galpavlin/BESC-G2/pictures/besc g2 bottom.png

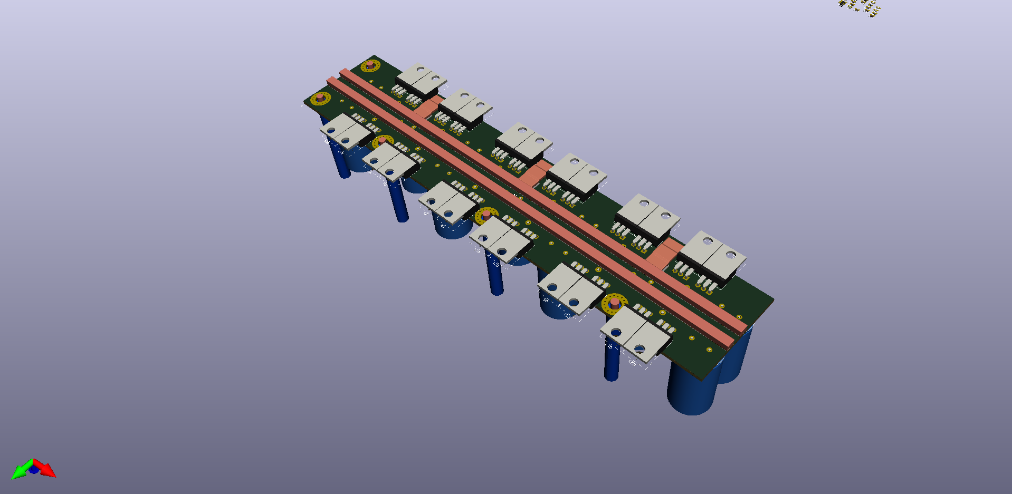
pictures/besc g2 bottom.png
