galpavlin/BESC-G2/pictures/besc g2 power stage layout.JPG

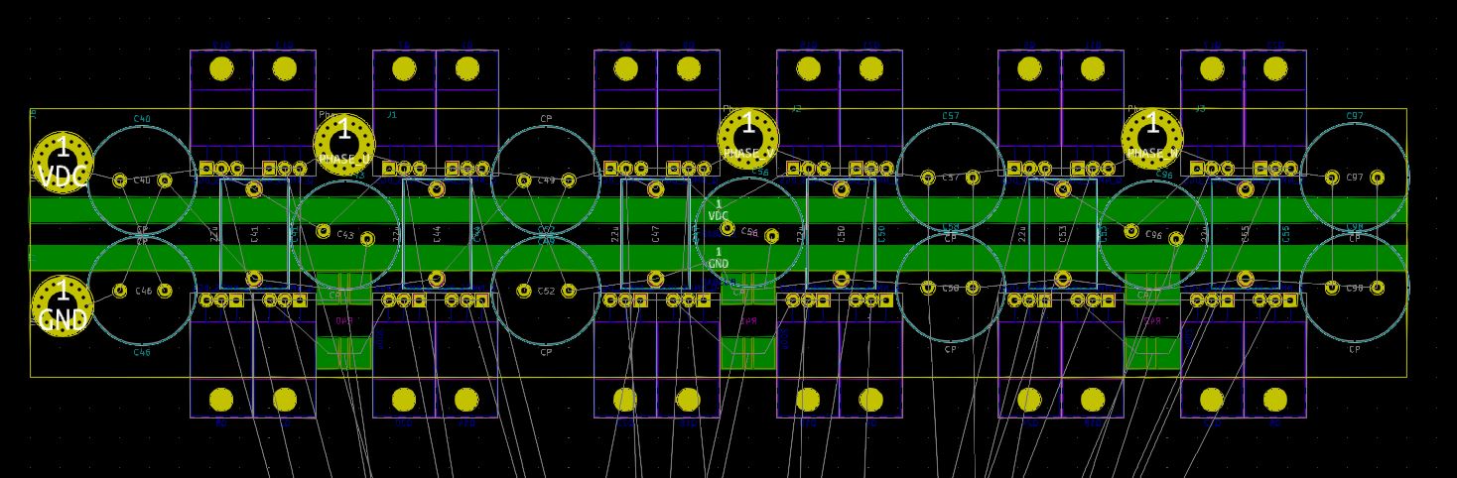
pictures/besc g2 power stage layout.JPG
