galpavlin/BESC-G2/pictures/besc g2 top.png

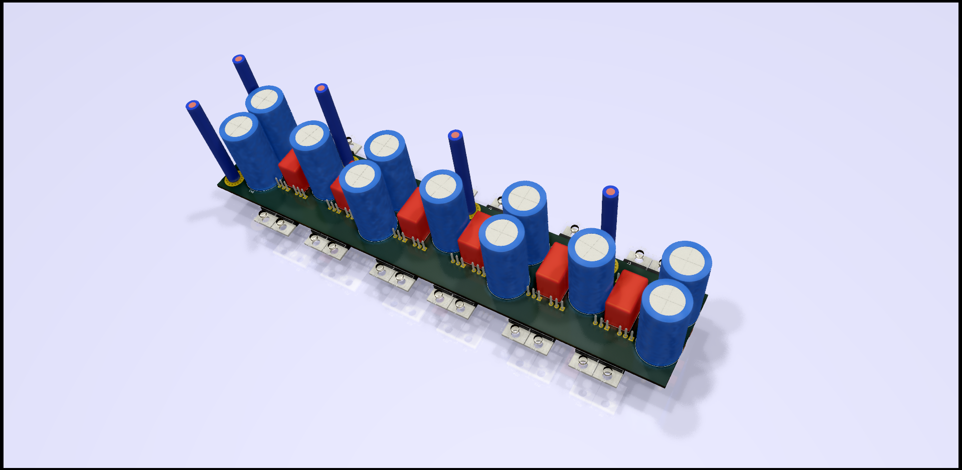
pictures/besc g2 top.png
