galpavlin/BESC-G2/documentation/BESC G2 V1.1 BOM.ods

Designator | Value | Footprint | Quantity | manufacturer # | mouser # | farnell #
> C1-C3 | 2.2u 35V | Capacitor_SMD:C_0805_2012Metric | 3 | C2012X7R1V225M085AC | 810-C2012X7R1V225M8A
> C4-C9, C13-C15, C65-C67, C104 | 270p | Capacitor_SMD:C_0603_1608Metric | 13 | C0603C271J5GACTU | 80-C0603C271J5G
> C19-C24, C100, C110-C112, C114 | 4.7u 25V | Capacitor_SMD:C_1206_3216Metric | 11 | VJ1206Y475KXXTW1BC | 77-VJ126Y475KXXTW1BC
> C25-C30, C75, C77, C79-C81, C85, C91 | 10n | Capacitor_SMD:C_0603_1608Metric | 13 | 885012206089 | 710-885012206089
> C10-C12, C16-C18, C31-C33, C63, C68-C71, C74, C82, C84, C86-C88, C90, C96, C101 | 100n | Capacitor_SMD:C_0603_1608Metric | 23 | 885012206071 | 710-885012206071
> C34-C39, C54, C62, C64, C76, C78, C83, C89, C95, C99, C102, C103, C106, C109 | 2.2u | Capacitor_SMD:C_0603_1608Metric | 19 | 885012207001 | 710-885012207001
> C40, C43, C46, C49, C52, C56-C61 | B41858C9477M000 | Capacitor_THT:C_Radial_D18.0mm_H25mm_P7.50mm | 11 | B41858D9337M000 | 871-B41858D9337M
> C41, C44, C47, C50, C53, C55 | F611BY685K100A | Capacitor_THT:C_Rect_L18.0mm_W11.0mm_P15.00mm_FKS3_FKP3 | 6 | F611BY685K100A | 80-F611BY685K100A | 2808222
> C42, C45, C48, C51 | C1206C105K1RACTU | Capacitor_SMD:C_1206_3216Metric | 4 | C1206C105K1RACTU | 80-C1206C105K1R
> C72, C73 | 15p | Capacitor_SMD:C_0603_1608Metric | 2 | 885012006052 | 710-885012006052
> C92-C94, C98 | 0.47u 200V | Capacitor_SMD:C_1210_3225Metric | 4 | MC1210B474K201CT | 80-C1210X474K1RAUTO | 1855950
C97 | 100u | Capacitor_Tantalum_SMD:CP_EIA-6032-28_Kemet-C | 1 | TAJD107M016RNJ | 581-TAJD107M016R
C105 | 130p | Capacitor_SMD:C_0603_1608Metric | 1 | GRM1885C1H131GA01D | 81-GRM1885C1H131GA1D
C107 | 47n | Capacitor_SMD:C_0603_1608Metric | 1 | 885012206044 | 710-885012206044
C108 | 10p | Capacitor_SMD:C_0603_1608Metric | 1 | 885012006051 | 710-885012006051
> C115-C117 | TR3D157K016C0075 | Capacitor_Tantalum_SMD:CP_EIA-7343-31_Kemet-D | 3 | TR3D157K016C0075 | 74-293D157X9016D2TE3 | 2353189
> D1-D3 | SS115+ | Diode_SMD:D_SMA | 3 | SS115+ | 821-SS115F3 | 2675131
D7 | MMSZ5231BT1G | Diode_SMD:D_SOD-123 | 1 | MMSZ5231BT1G | 863-MMSZ5231BT1G | 1431273
D9 | 12.7V | Diode_SMD:D_SMA | 1 | SMAJ12A-TR | 511-SMAJ12A-TR | 9802754
> FB1-FB3, FB7, FB8 | BLM18AG102SN1D | Inductor_SMD:L_0603_1608Metric | 5 | BLM18AG102SN1D | 81-BLM11A102S
IC1 | LTC7801 | Package_DFN_QFN:QFN-24-1EP_4x5mm_P0.5mm_EP2.65x3.65mm | 1 | LTC7801EUFD#PBF | 584-LTC7801EUFDPBF
J10 | 614105150721 | Connector_USB:USB_Micro-B_Wuerth_614105150721_Vertical_CircularHoles | 1 | 614105150721 | 710-614105150721
J17 | 12V OUT | conn-amass:AMASS_XT30U-M_1x02_P5.0mm_Vertical | 1 | XT30U |  |  | check TME for original | you can get knockoff on ebay
L1 | 7443633300 | moje:WE-HCF-2013 | 1 | 7443633300 | 710-7443633300
> Q1-Q24 | IRF135B203 | moje:TO-220-3_hor_tabup | 24 | IRF135B203 | 942-IRF135B203 | 2709931
Q25 | FDMS86252L | moje:TDSON-8-MOS | 1 | FDMS86252L | 512-FDMS86252L
Q26 | BSC110N15NS5 | moje:TDSON-8-MOS | 1 | BSC110N15NS5 | 726-BSC160N15NS5ATMA | 2803377
> R1-R9, R83, R86 | 60R4 | Resistor_SMD:R_0603_1608Metric | 11 | CRCW060360R4FKEAC | 71-CRCW060360R4FKEAC
> R10-R12 | 2.2R | Resistor_SMD:R_1206_3216Metric | 3 | RCG12062R20JNEA | 71-RCG12062R20JNEA
> R13-R18, R22-R24, R66-R73, R75, R76, R79-R82 | 2k2 | Resistor_SMD:R_0603_1608Metric | 23 | CRGCQ0603F2K2 | 279-CRGCQ0603F2K2
> R31-R33 | 200u | moje:LRMAP5930x | 3 | LRMAP5930B-R0002FT | 66-LRMAP5930BR0002FT
> R25-R30, R34-R51, R93 | 10R | Resistor_SMD:R_0805_2012Metric | 25 | CRCW080510R0FKEAC | 71-CRCW080510R0FKEAC
> R52, R54, R56, R63 | 150k | Resistor_SMD:R_0805_2012Metric | 4 | CRCW0805150KFKEA | 71-CRCW0805-150K-E3
> R53, R55, R57, R64 | 3k24 | Resistor_SMD:R_0603_1608Metric | 4 | CRCW06033K24FKEA | 71-CRCW0603-3.24K-E3
> R58, R59, R61, R62 | 1R | Resistor_SMD:R_1206_3216Metric | 4 | RCG12061R00JNEA | 71-RCG12061R00JNEA
> R19-R21, R60, R92 | 10k | Resistor_SMD:R_0603_1608Metric | 5 | SFR03EZPF1002 | 755-SFR03EZPF1002
> R74, R87 | 330R | Resistor_SMD:R_0603_1608Metric | 2 | CRCW0603330RFKEAC | 71-CRCW0603330RFKEAC
> R77, R78 | 24R | Resistor_SMD:R_0603_1608Metric | 2 | RC0603FR-1324R9L | 603-RC0603FR-1324R9L
> R84, R85, R94 | 30k1 | Resistor_SMD:R_0603_1608Metric | 3 | CRCW060330K1FKEA | 71-CRCW0603-30.1K-E3
R88 | 1M | Resistor_SMD:R_0603_1608Metric | 1 | RC0603FR-071ML | 603-RC0603FR-071ML
R89 | 9k1 | Resistor_SMD:R_0603_1608Metric | 1 | RC0603FR-079K1L | 603-RC0603FR-079K1L
> R90, R91, R96 | 80k6 | Resistor_SMD:R_0603_1608Metric | 3 | CRCW060380K6FKEA | 71-CRCW0603-80.6K-E3
R95 | 71.5k | Resistor_SMD:R_0603_1608Metric | 1 | CR0603-FX-7152ELF | 652-CR0603FX-7152ELF
R97 | 255k | Resistor_SMD:R_0603_1608Metric | 1 | RC0603FR-13255KL | 603-RC0603FR-13255KL
R98 | 60k4 | Resistor_SMD:R_0603_1608Metric | 1 | CR0603-FX-6042ELF | 652-CR0603FX-6042ELF
R99 | 4k32 | Resistor_SMD:R_0603_1608Metric | 1 | RC0603FR-074K32L | 603-RC0603FR-074K32L
TH1 | 10k | Resistor_SMD:R_0603_1608Metric | 1 | NCU18XH103F6SRB | 81-NCU18XH103F6SRB
> U1-U3 | UCC21520DW | Package_SO:SOIC-16W_7.5x10.3mm_P1.27mm | 3 | UCC21520DWR | 595-UCC21520DWR
> U4-U6 | INA240A1D | Package_SO:SOIC-8_3.9x4.9mm_P1.27mm | 3 | INA240A1D | 595-INA240A1D
U8 | STM32F405RGTx | Package_QFP:LQFP-64_10x10mm_P0.5mm | 1 | STM32F405RGT6 | 511-STM32F405RGT6
U9 | USBLC6-2SC6 | Package_TO_SOT_SMD:SOT-666 | 1 | USBLC6-2SC6 | 511-USBLC6-2SC6
U10 | TJA1051T-3 | Package_SO:SOIC-8_3.9x4.9mm_P1.27mm | 1 | TJA1051T-3 | 771-TJA1051T/3/1J
U11 | R-78E5.0-0.5 | Converter_DCDC:Converter_DCDC_RECOM_R-78E-0.5_THT | 1 | R-78E5.0-0.5 | 919-R-78E5.0-0.5
U12 | LP5907MFX-3.3 | Package_TO_SOT_SMD:SOT-23-5 | 1 | LP5907MFX-3.3 | 595-LP5907MFX-3.3NPB
Y1 | MCSJK-7I-8.00-18-10-60-B-10 | Crystal:Crystal_SMD_5032-4Pin_5.0x3.2mm | 1 | MCSJK-7I-8.00-18-10-60-B-10 | ECS-80-8-30Q-VY-TR | 2854012
Stuff that's probably already somewhere on your workbench
D4 | RED | LED_SMD:LED_0603_1608Metric | 1 | common 0603 LED
D5 | GREEN | LED_SMD:LED_0603_1608Metric | 1 | common 0603 LED
D6 | BLUE | LED_SMD:LED_0603_1608Metric | 1 | common 0603 LED
D8 | LED | LED_SMD:LED_0603_1608Metric | 1 | common 0603 LED
> FID1-FID6 | Fiducial | Fiducial:Fiducial_0.5mm_Mask1.5mm | 6 | mechanical
> H1-H9 | M3 | MountingHole:MountingHole_3.2mm_M3_Pad_Via | 9 | mechanical
> J1-J3 | PHASE WIRE | moje:8awg_wirepad | 3 | 8 AWG silicone wire BLUE + cable lug
> J4, J5 | BUSBAR | moje:busbar1 | 2 | 3x4x230 square copper profile
J6 | IN+ | moje:8awg_wirepad | 1 | 8 AWG silicone wire RED + cable lug
J7 | IN- | moje:8awg_wirepad | 1 | 8 AWG silicone wire BLACK + cable lug
J8 | SWD | Connector_PinHeader_2.54mm:PinHeader_1x05_P2.54mm_Vertical | 1 | common 2.54 5 pin header
J9 | RC PWM | Connector_PinHeader_2.54mm:PinHeader_1x03_P2.54mm_Vertical | 1 | 3 pin JST cable assembly | https://www.aliexpress.com/item/32889207283.html?spm=2114.search0104.3.2.201e7038qpjDAU
J11 | THROTTLE | Connector_PinHeader_2.54mm:PinHeader_1x03_P2.54mm_Vertical | 1 | 3 pin JST cable assembly | https://www.aliexpress.com/item/32889207283.html?spm=2114.search0104.3.2.201e7038qpjDAU
J12 | MOTOR SENSOR | Connector_PinHeader_2.54mm:PinHeader_1x06_P2.54mm_Vertical | 1 | 6 pin JST cable assembly | https://www.aliexpress.com/item/32889207283.html?spm=2114.search0104.3.2.201e7038qpjDAU
J13 | THROTTLE 2 (BRAKE) | Connector_PinHeader_2.54mm:PinHeader_1x03_P2.54mm_Vertical | 1 | 3 pin JST cable assembly | https://www.aliexpress.com/item/32889207283.html?spm=2114.search0104.3.2.201e7038qpjDAU
J14 | SERIAL | Connector_PinHeader_2.54mm:PinHeader_1x05_P2.54mm_Vertical | 1 | 5 pin JST cable assembly | https://www.aliexpress.com/item/32889207283.html?spm=2114.search0104.3.2.201e7038qpjDAU
J15 | IGNITION | Connector_PinHeader_2.54mm:PinHeader_1x02_P2.54mm_Vertical | 1 | 2 pin JST cable assembly | https://www.aliexpress.com/item/32889207283.html?spm=2114.search0104.3.2.201e7038qpjDAU
J16 | CAN | Connector_PinHeader_2.54mm:PinHeader_1x04_P2.54mm_Vertical | 1 | 4 pin JST cable assembly | https://www.aliexpress.com/item/32889207283.html?spm=2114.search0104.3.2.201e7038qpjDAU
thermal interface pad |  |  | 85 cm^2 | 0.5mm thermal silicone pad | https://www.ebay.com/itm/400mm-x-205mm-x-0-5mm-Silicone-Thermal-Pad-for-CPU-GPU-Heatsink-AD/112077304497
enclosure | 45x120x240 mm | you have to aks for custom lenght | 1 | SZOMK AK-C-B68 | https://www.aliexpress.com/item/1445241428.html
PCB |  |  | 1
