galpavlin/BESC-G2/3d/bus bar.SLDPRT

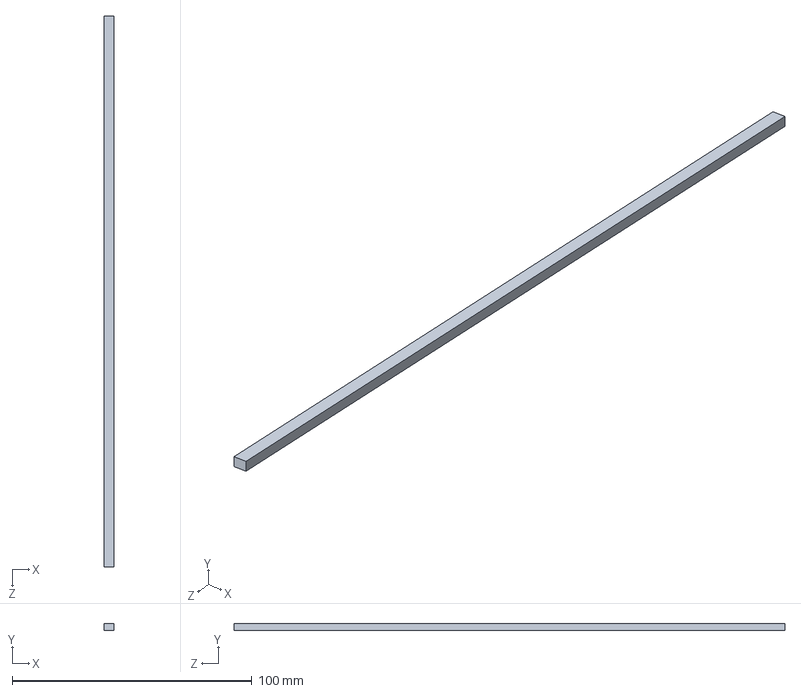
[picture p4: CAD file, 2019-08-21]
3d/bus bar.SLDPRT
4.00 x 3.00 x 230.0 mm
