galpavlin/BESC-G2/3d/enclosure/3d print/top plastic 1.STL

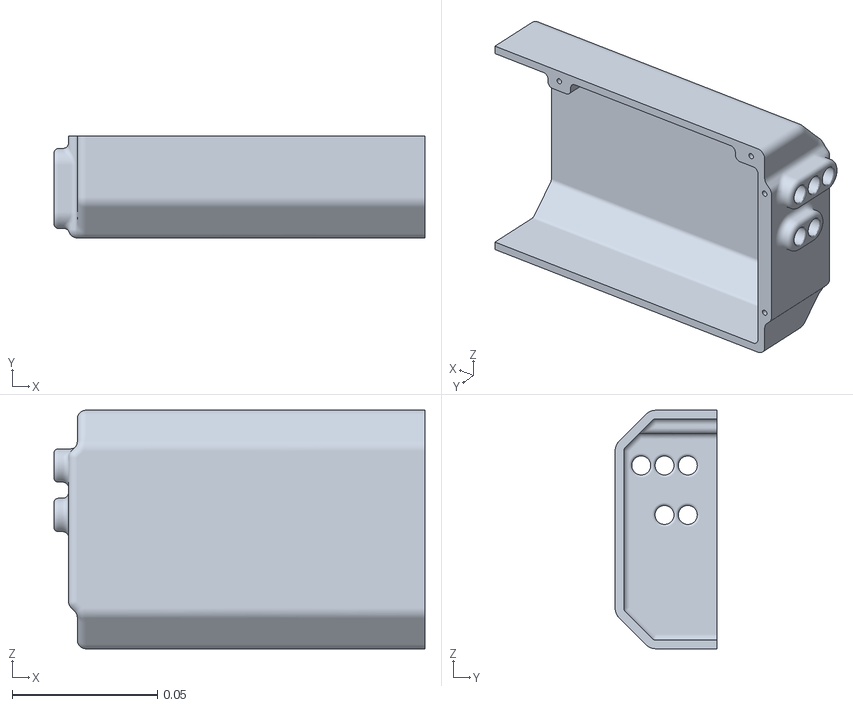
[picture p5: CAD file, 2020-08-25]
3d/enclosure/3d print/top plastic 1.STL
0.127 x 0.035 x 0.082
