galpavlin/BESC-G2/3d/enclosure/3d print/spacers2.STL

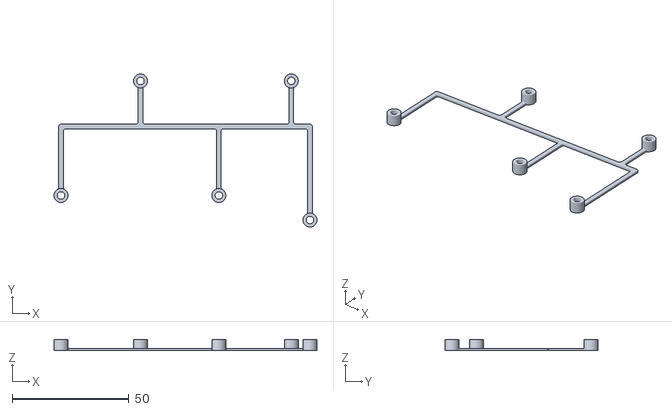
[picture p6: CAD file, 2020-08-25]
3d/enclosure/3d print/spacers2.STL
112.5 x 65.5 x 4.80
