galpavlin/BESC-G2/3d/enclosure/3d print/spacers1.STL

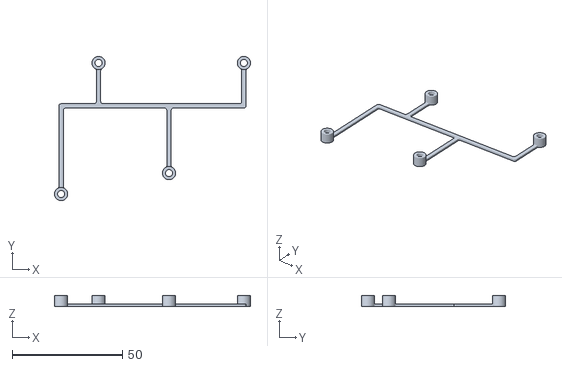
[picture p7: CAD file, 2020-08-25]
3d/enclosure/3d print/spacers1.STL
89.0 x 65.5 x 4.80
