galpavlin/BESC-G2/3d/enclosure/3d print/top plastic.STEP

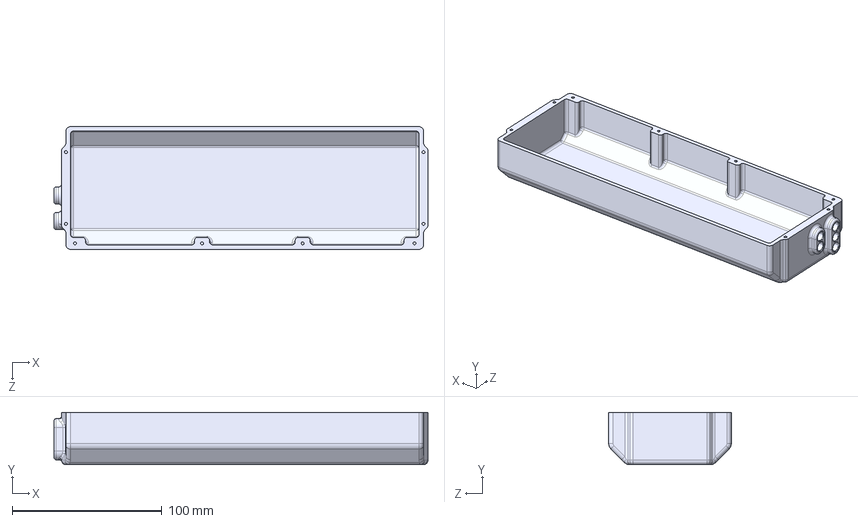
[picture p8: CAD file, 2020-08-25]
3d/enclosure/3d print/top plastic.STEP
250.0 x 35.0 x 82.0 mm
