galpavlin/BESC-G2/3d/enclosure/3d print/top plastic 2.STL

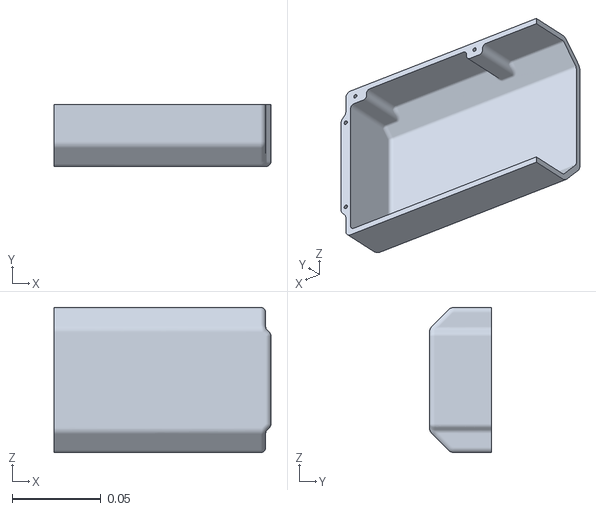
[picture p9: CAD file, 2020-08-25]
3d/enclosure/3d print/top plastic 2.STL
0.123 x 0.035 x 0.082
