galpavlin/BESC-G2/3d/enclosure/3d print/spacers.STL

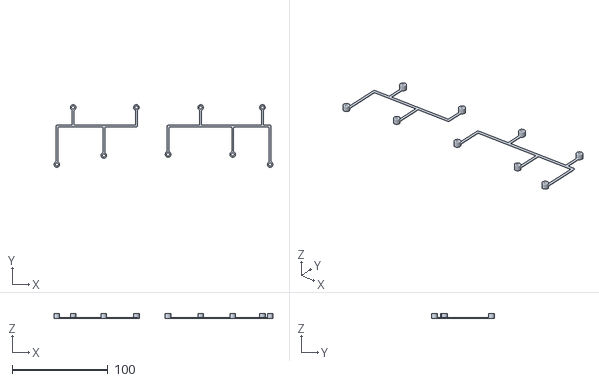
[picture p10: CAD file, 2020-08-25]
3d/enclosure/3d print/spacers.STL
228.5 x 65.5 x 4.80
