galpavlin/BESC-G2/documentation/besc g2.pdf

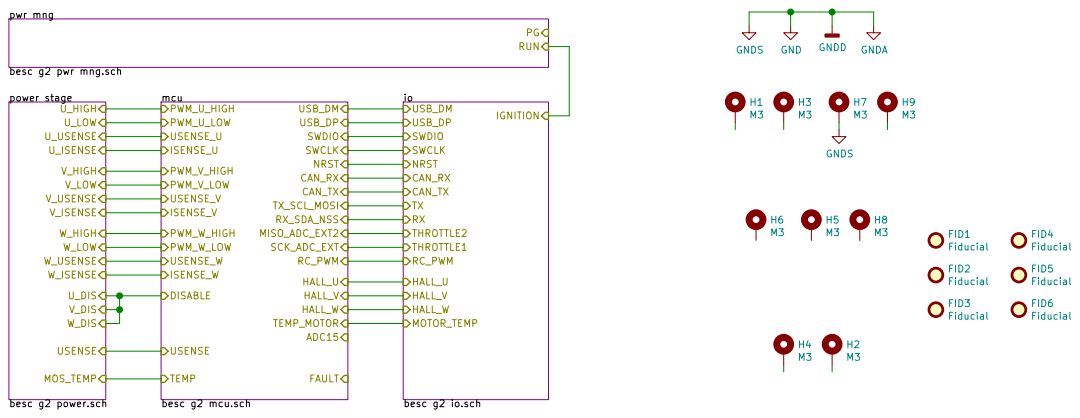
[picture p11: page 1]

RUN
besc g2 io.sch CAN_TX CAN_RX NRST SWDIO
SWCLK RC_PWM
FAULT CAN_RX CAN_TX

File: besc g2.sch Sheet: / e.pavlin.si

Id: 1/5 Title: BESC Gen 2

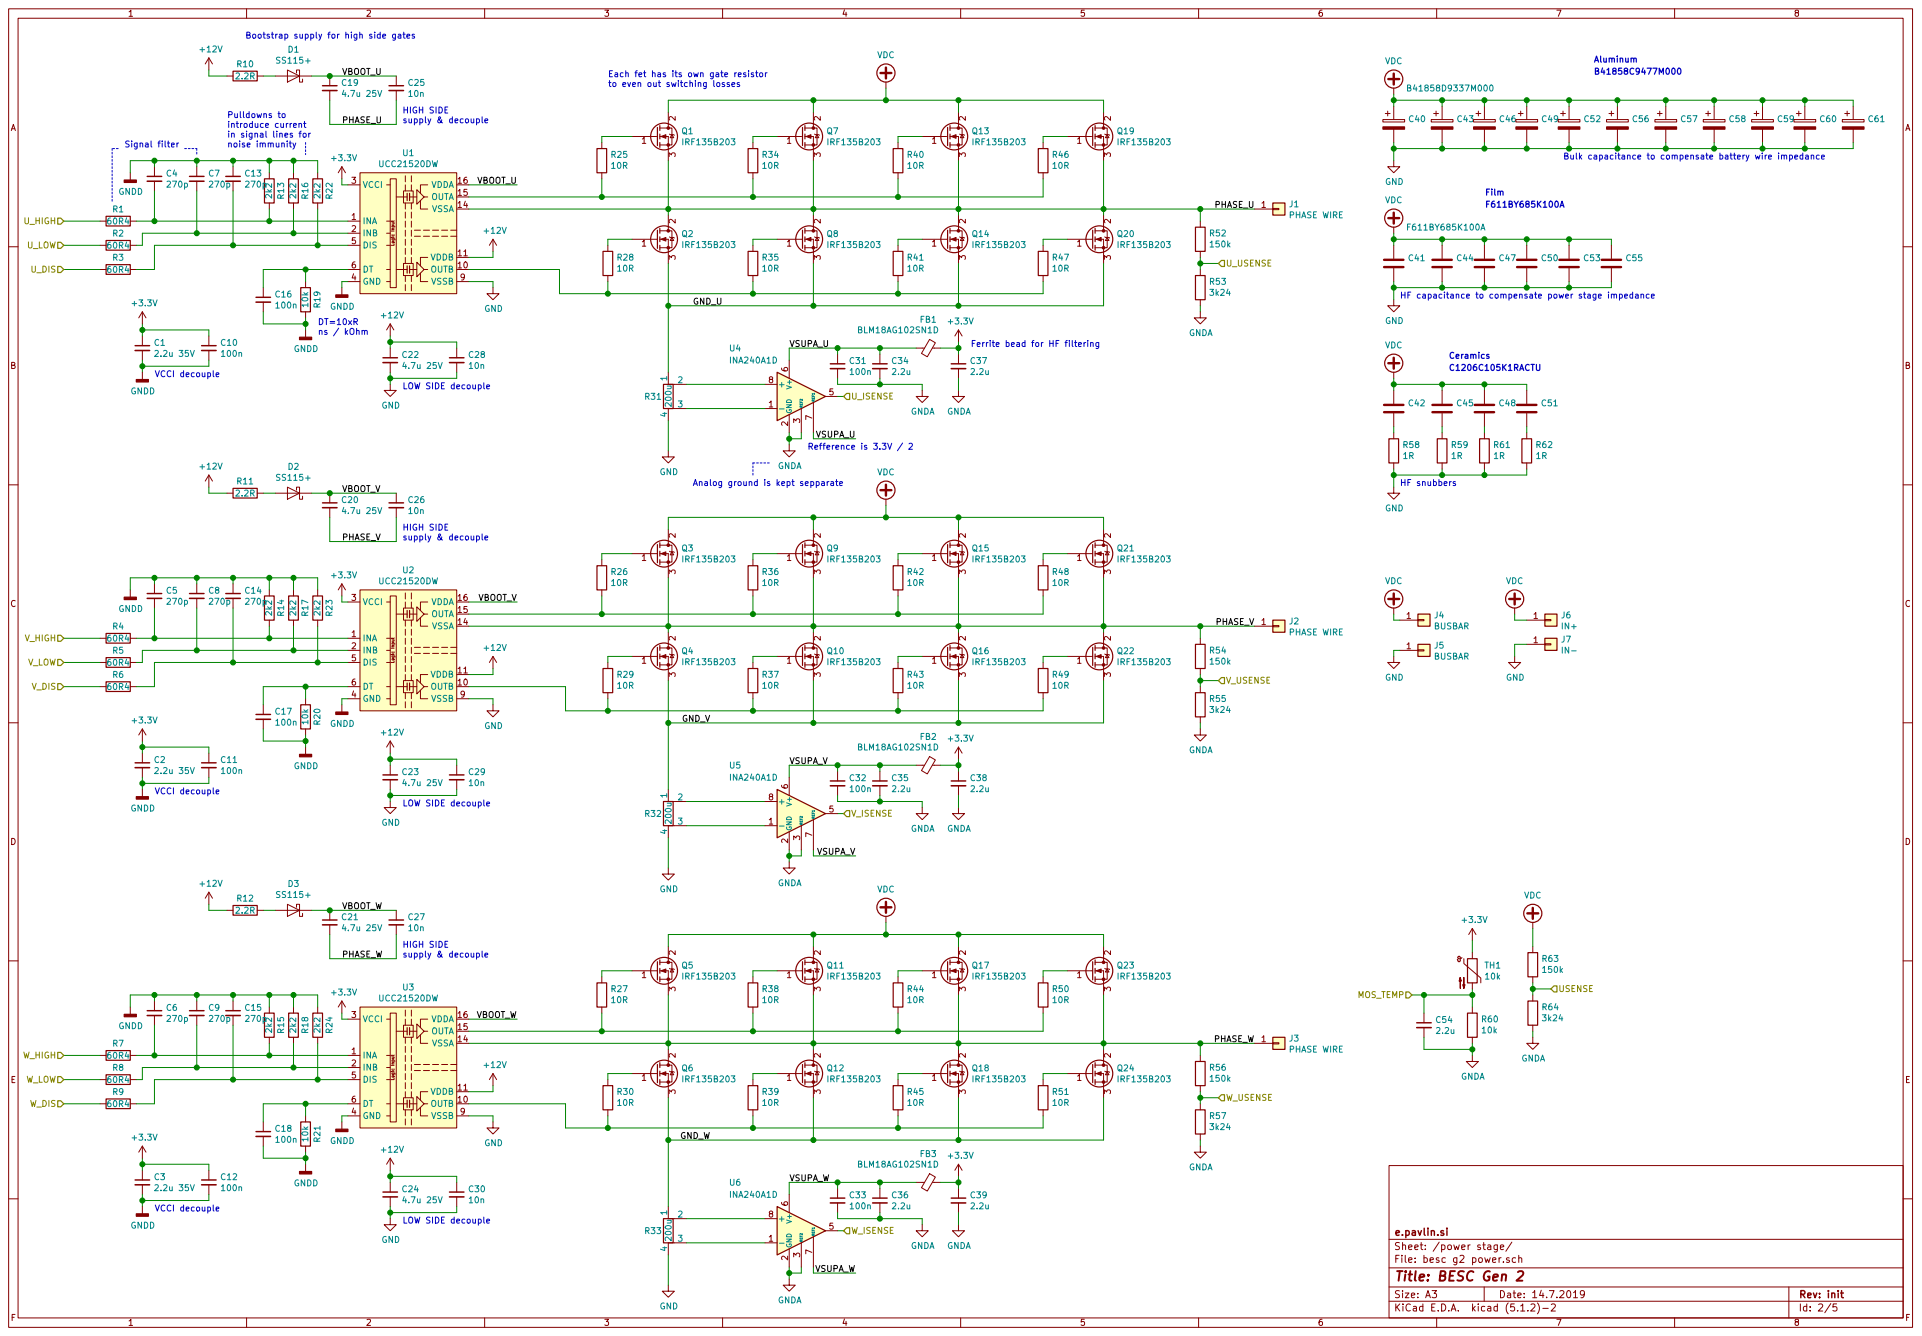
[picture p12: page 2]

Bootstrap supply for high side gates

Each fet has its own gate resistor
to even out switching losses

HF capacitance to compensate power stage impedance HF snubbers Pulldowns to
introduce current
in signal lines for
noise immunity

Bulk capacitance to compensate battery wire impedance

Analog ground is kept sepparate C22
10n GND

e.pavlin.si
Sheet: /power stage/
File: besc g2 power.sch
Id: 2/5 Title: BESC Gen 2

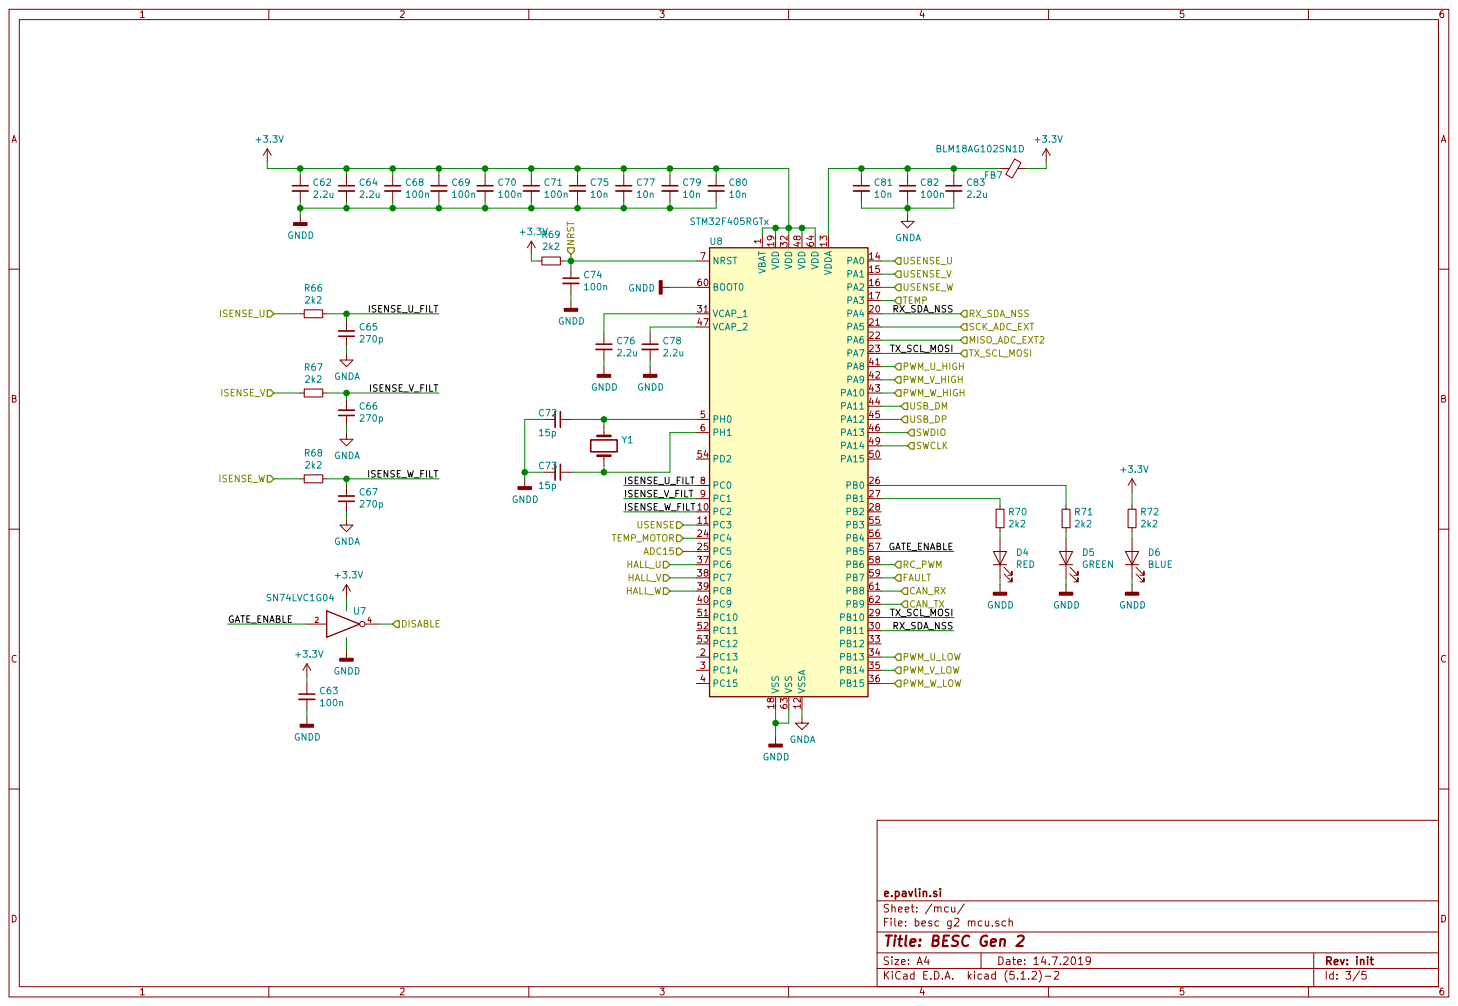
[picture p13: page 3]

1 VCAP_1 31 VCAP_2 47 VDD 19 VDD 32 VDD 48 VDD 64 VDDA 13 VSS 18 VSS 63 VSSA 12 U8 STM32F405RGTx PWM_U_HIGH

File: besc g2 mcu.sch Sheet: /mcu/ e.pavlin.si

Id: 3/5 Title: BESC Gen 2

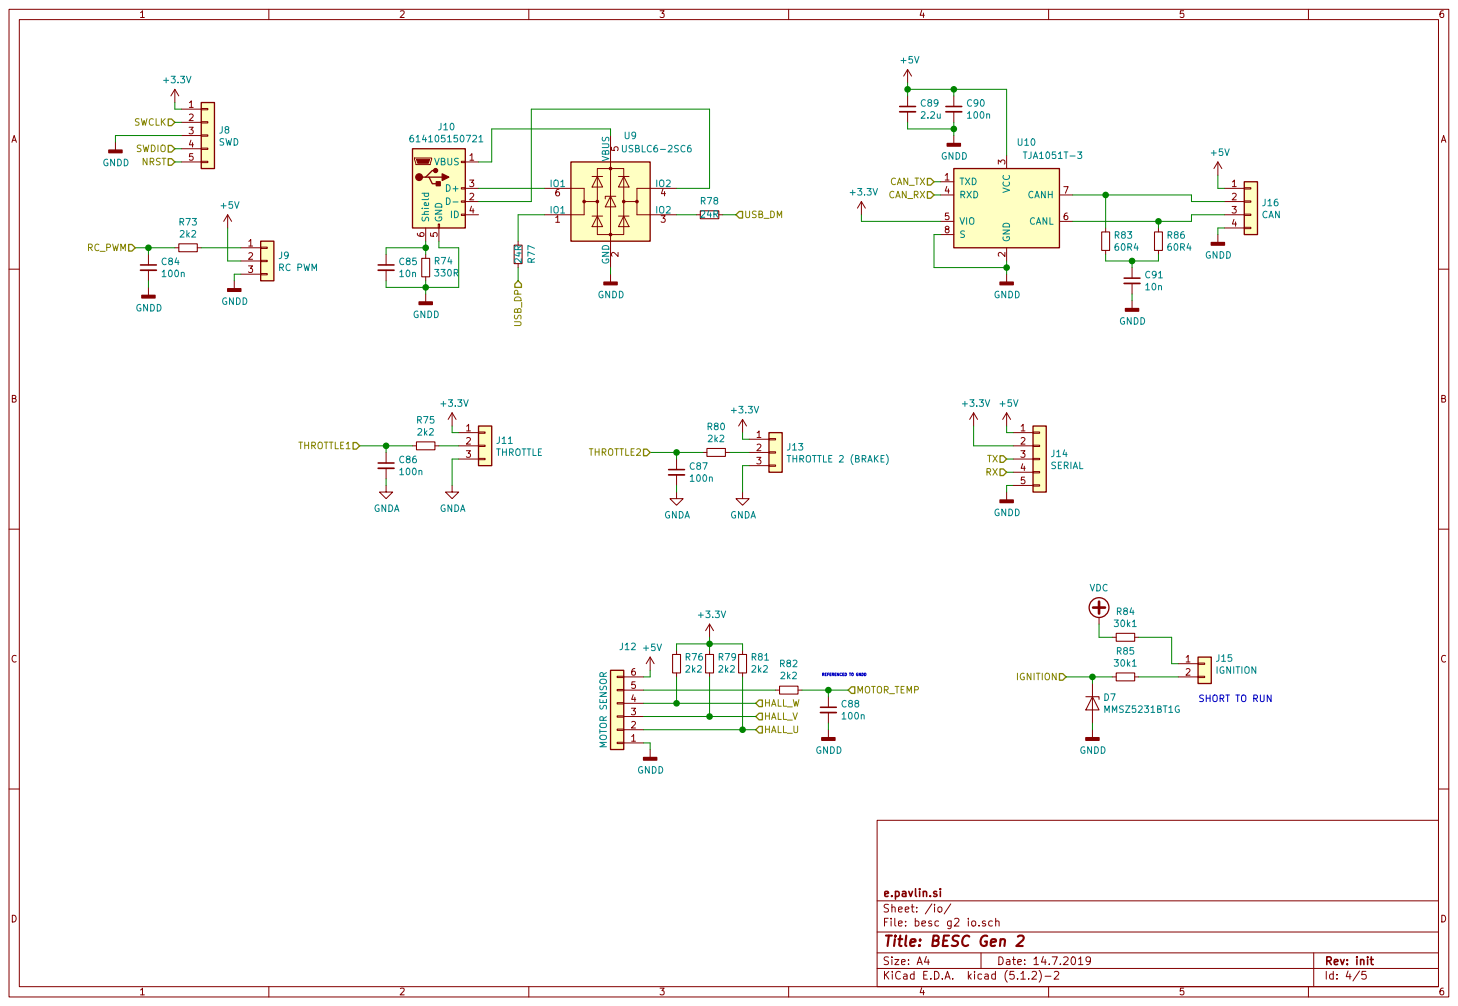
[picture p14: page 4]

3 RXD 4 VIO 5 CANL 6 CANH 7 S

File: besc g2 io.sch Sheet: /io/ e.pavlin.si

Id: 4/5 Title: BESC Gen 2

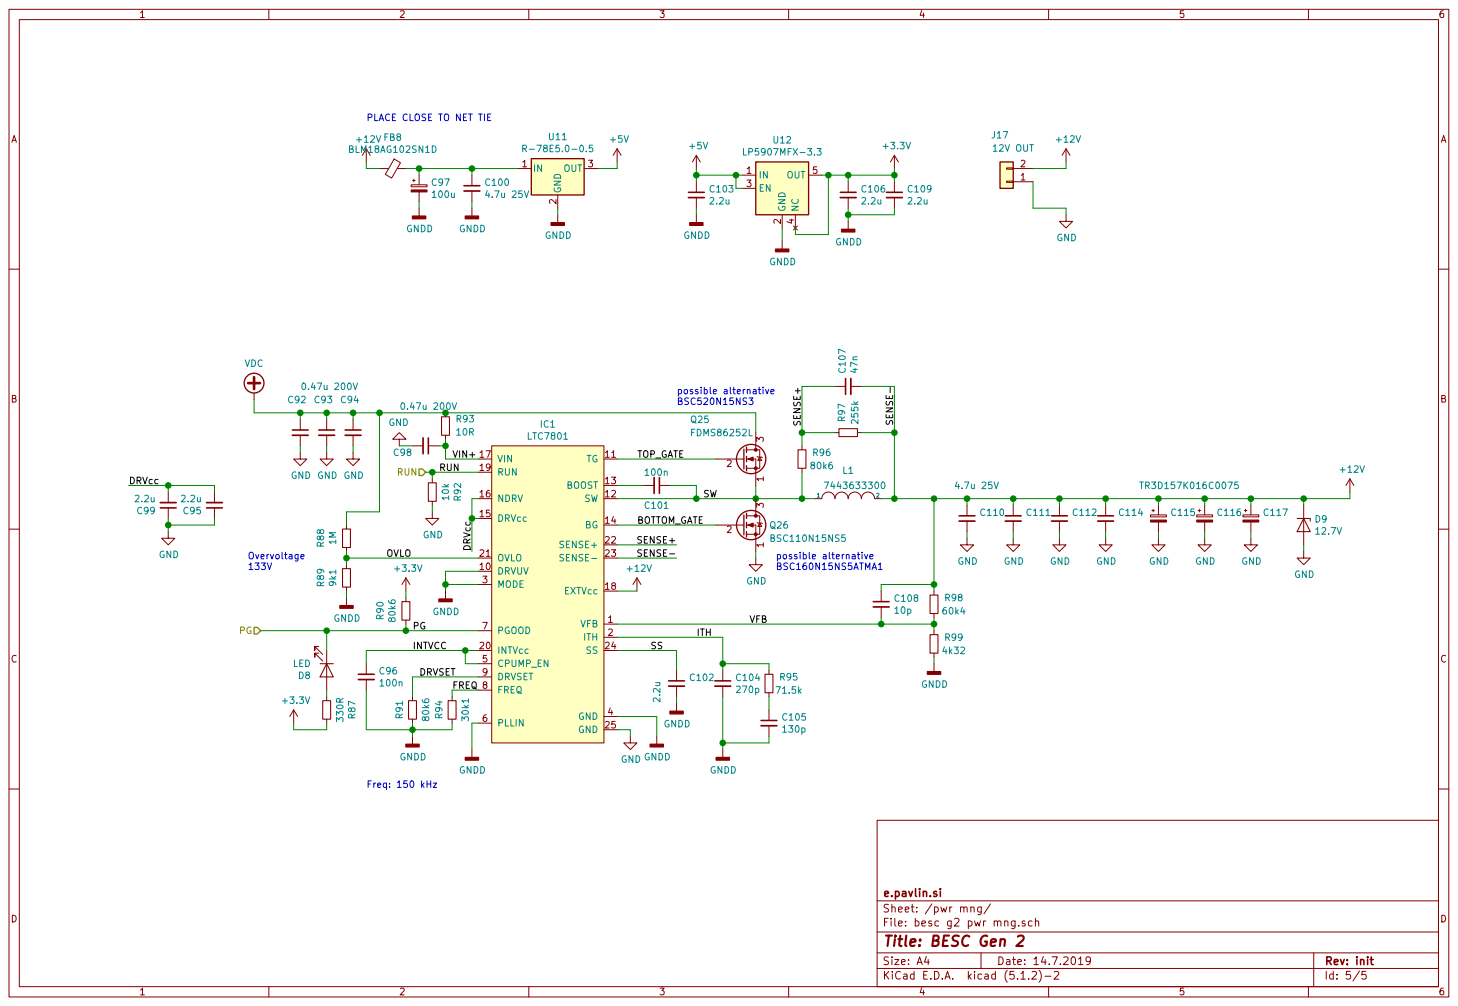
[picture p15: page 5]

3 Q25 FDMS86252L VFB 1 DRVUV 10 TG 11 SW 12 BOOST 13 BG DRVcc 14

e.pavlin.si
Sheet: /pwr mng/
File: besc g2 pwr mng.sch
Id: 5/5 Title: BESC Gen 2
