galpavlin/BESC-G2/documentation/assembly drawing.pdf

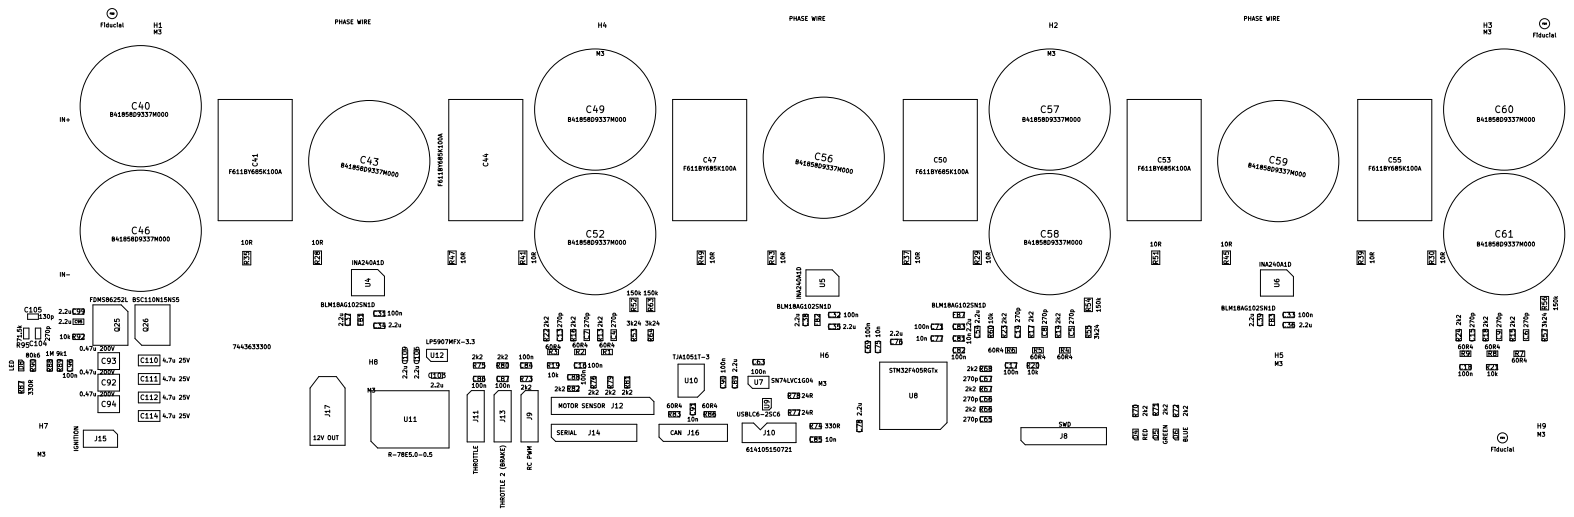
[picture p16: page 1]

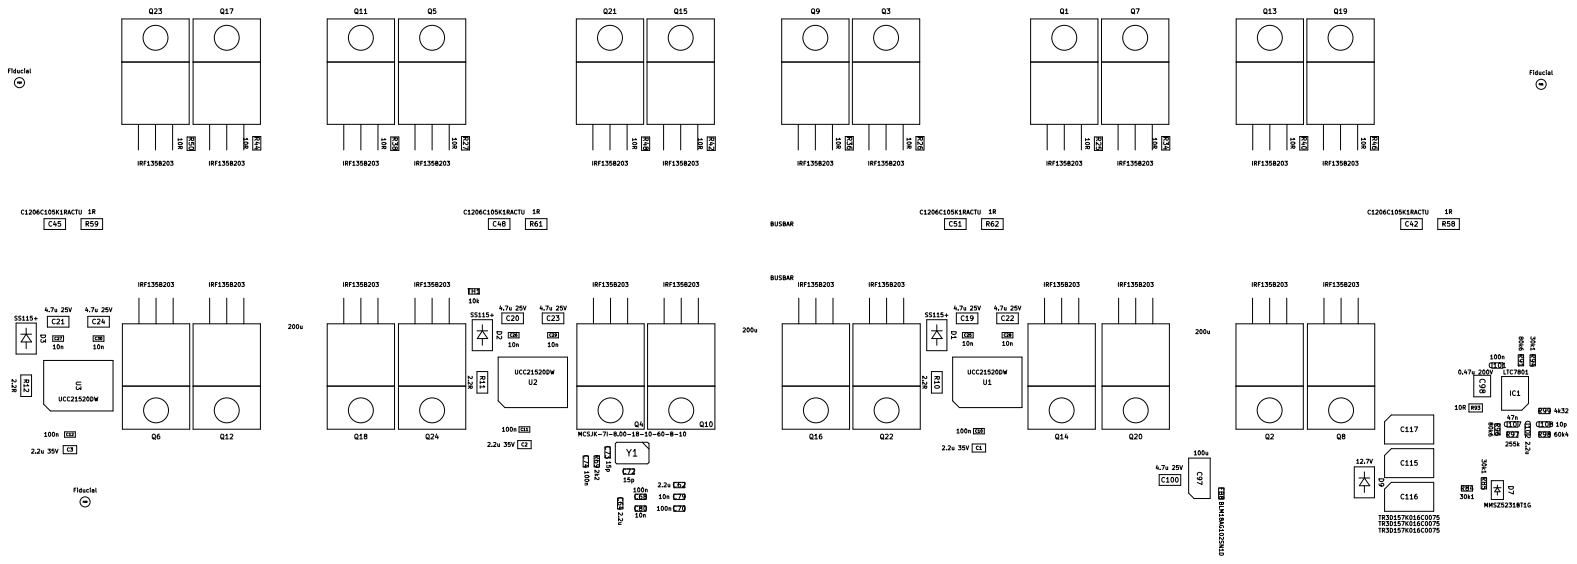
[picture p17: page 2]
