galpavlin/BESC-G2/besc g2.kicad_pcb

## KiCad design besc g2.kicad_pcb (2021-05-26)

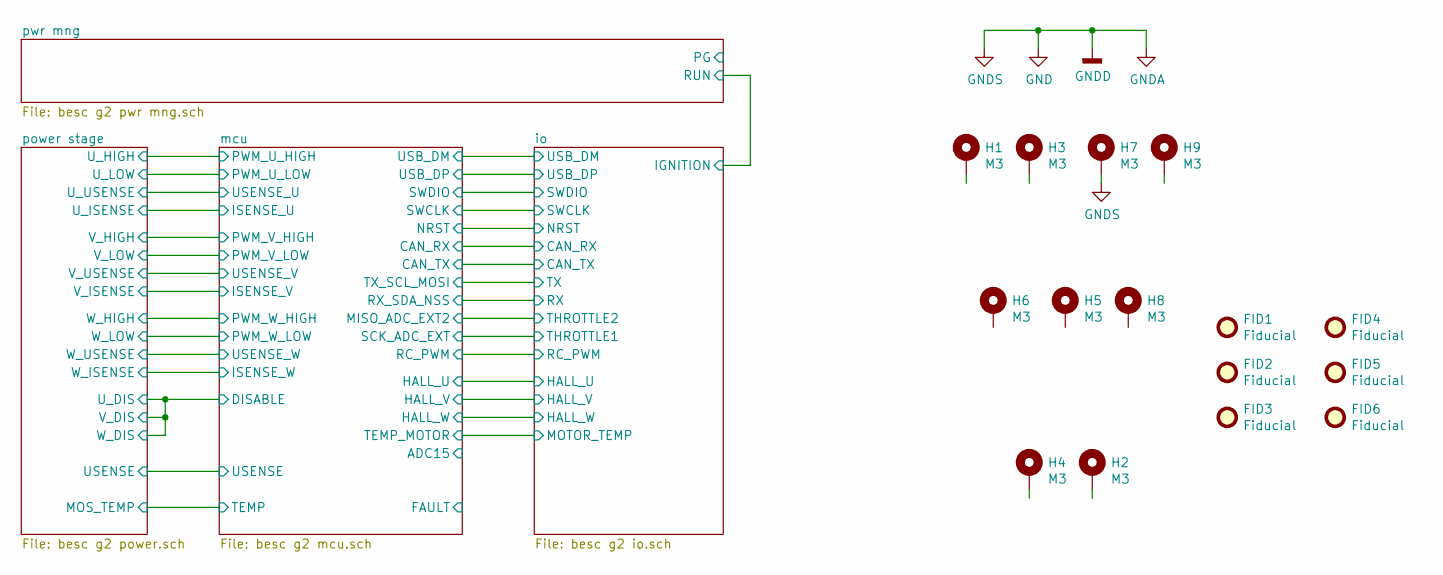
[picture p18: schematic besc g2.sch, BESC Gen 2]

Parts:
FID1, FID2, FID3, FID4, FID5, FID6: Fiducial; Fiducial_0.5mm_Mask1.5mm
H1, H2, H3, H4, H5, H6, H7, H8, H9: M3; MountingHole_3.2mm_M3_Pad_Via

Connections:
GND: H7.1; also elsewhere on the board

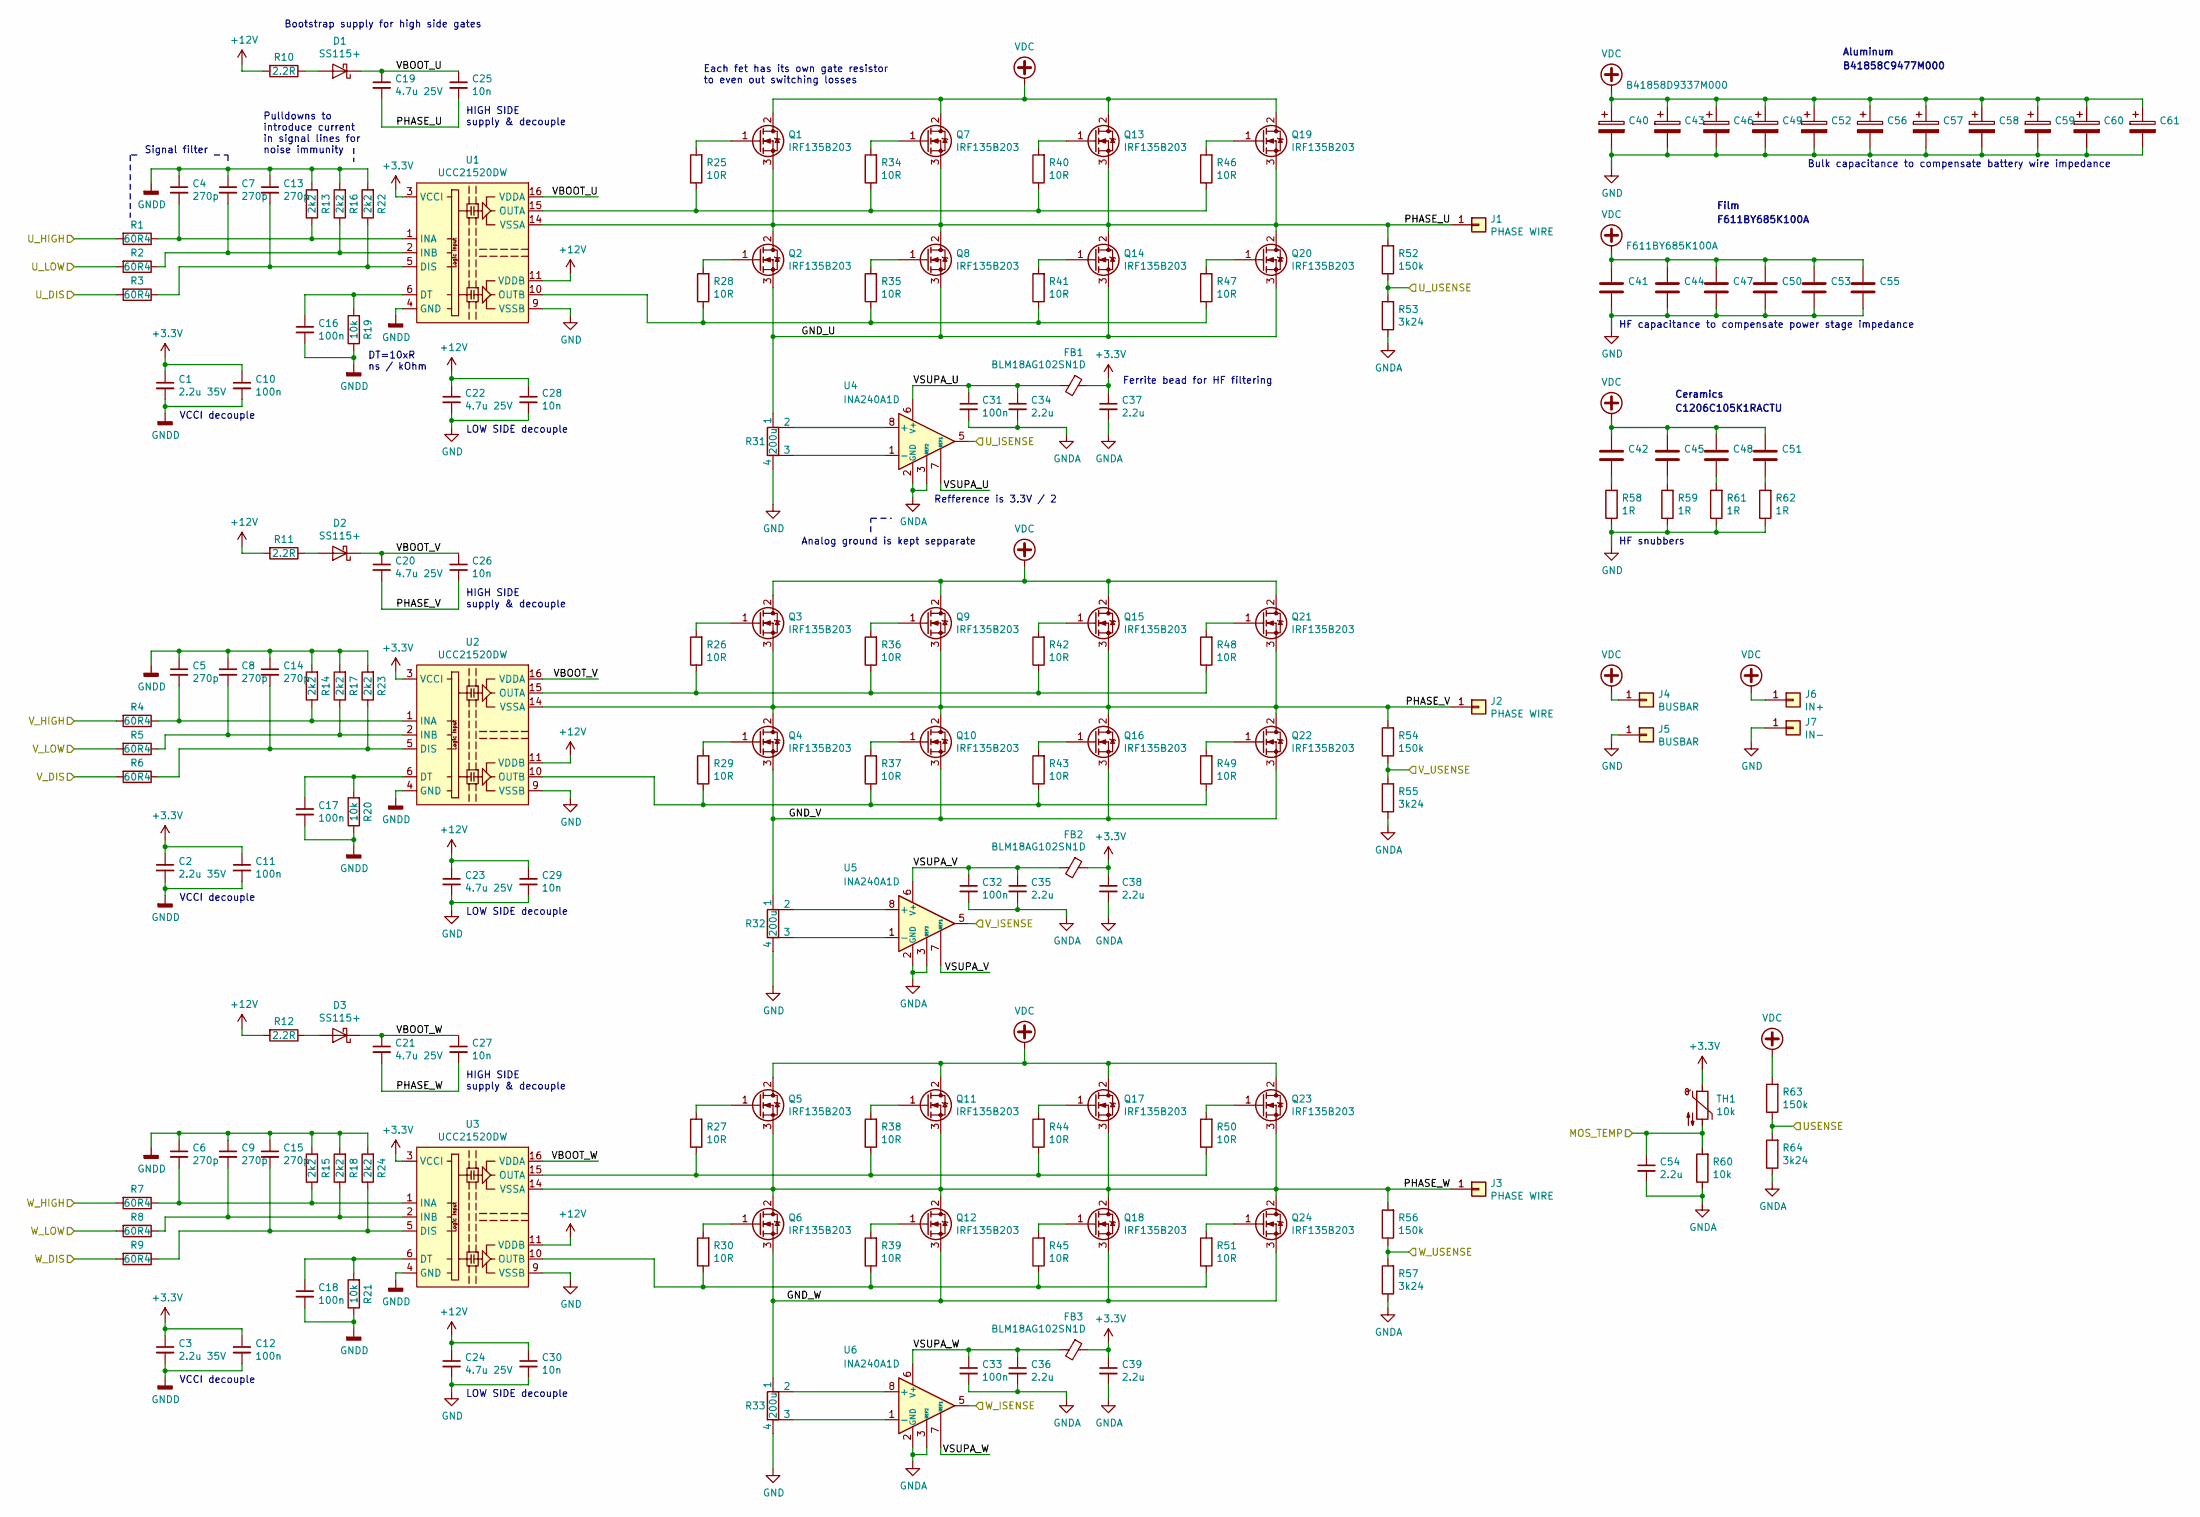
[picture p19: schematic besc g2 power.sch, BESC Gen 2]

Parts:
C1, C2, C3: 2.2u 35V; C_0805_2012Metric
C4, C5, C6, C7, C8, C9, C13, C14, C15: 270p; C_0603_1608Metric
C10, C11, C12, C16, C17, C18, C31, C32, C33: 100n; C_0603_1608Metric
C19, C20, C21, C22, C23, C24: 4.7u 25V; C_1206_3216Metric
C25, C26, C27, C28, C29, C30: 10n; C_0603_1608Metric
C34, C35, C36, C37, C38, C39, C54: 2.2u; C_0603_1608Metric
C40, C43, C46, C49, C52, C56, C57, C58, C59, C60, C61: B41858D9337M000; C_Radial_D18.0mm_H25mm_P7.50mm
C41, C44, C47, C50, C53, C55: F611BY685K100A; C_Rect_L18.0mm_W11.0mm_P15.00mm_FKS3_FKP3
C42, C45, C48, C51: C1206C105K1RACTU; C_1206_3216Metric
D1, D2, D3: SS115+; D_SMA
FB1, FB2, FB3: BLM18AG102SN1D; L_0603_1608Metric
J1, J2, J3: PHASE WIRE; 8awg_wirepad
J4, J5: BUSBAR; busbar1
J6: IN+; 8awg_wirepad
J7: IN-; 8awg_wirepad
Q1, Q2, Q3, Q4, Q5, Q6, Q7, Q8, Q9, Q10, Q11, Q12, Q13, Q14, Q15, Q16, Q17, Q18, Q19, Q20, Q21, Q22, Q23, Q24: IRF135B203; TO-220-3_hor_tabup
R1, R2, R3, R4, R5, R6, R7, R8, R9: 60R4; R_0603_1608Metric
R10, R11, R12: 2.2R; R_1206_3216Metric
R13, R14, R15, R16, R17, R18, R22, R23, R24: 2k2; R_0603_1608Metric
R19, R20, R21, R60: 10k; R_0603_1608Metric
R25, R26, R27, R28, R29, R30, R34, R35, R36, R37, R38, R39, R40, R41, R42, R43, R44, R45, R46, R47, R48, R49, R50, R51: 10R; R_0805_2012Metric
R31, R32, R33: 200u; LRMAP5930x
R52, R54, R56, R63: 150k; R_0805_2012Metric
R53, R55, R57, R64: 3k24; R_0603_1608Metric
R58, R59, R61, R62: 1R; R_1206_3216Metric
TH1: 10k; R_0603_1608Metric
U1, U2, U3: UCC21520DW; SOIC-16W_7.5x10.3mm_P1.27mm
U4, U5, U6: INA240A1D; SOIC-8_3.9x4.9mm_P1.27mm

Connections:
+3V3: C1.1, C2.1, C3.1, C10.1, C11.1, C12.1, C37.1, C38.1, C39.1, FB1.1, FB2.1, FB3.1, TH1.1, U1.3 (VCCI), U1.8 (VCCI), U2.3 (VCCI), U2.8 (VCCI), U3.3 (VCCI), U3.8 (VCCI); also elsewhere on the board
+12V: C22.1, C23.1, C24.1, C28.1, C29.1, C30.1, R10.2, R11.2, R12.2, U1.11 (VDDB), U2.11 (VDDB), U3.11 (VDDB); also elsewhere on the board
/mcu/DISABLE: R3.2, R6.2, R9.2; also elsewhere on the board
/mcu/ISENSE_U: U4.5; also elsewhere on the board
/mcu/ISENSE_V: U5.5; also elsewhere on the board
/mcu/ISENSE_W: U6.5; also elsewhere on the board
/mcu/PWM_U_HIGH: R1.2; also elsewhere on the board
/mcu/PWM_U_LOW: R2.2; also elsewhere on the board
/mcu/PWM_V_HIGH: R4.2; also elsewhere on the board
/mcu/PWM_V_LOW: R5.2; also elsewhere on the board
/mcu/PWM_W_HIGH: R7.2; also elsewhere on the board
/mcu/PWM_W_LOW: R8.2; also elsewhere on the board
/mcu/USENSE: R63.1, R64.2; also elsewhere on the board
/mcu/USENSE_U: R52.1, R53.2; also elsewhere on the board
/mcu/USENSE_V: R54.1, R55.2; also elsewhere on the board
/mcu/USENSE_W: R56.1, R57.2; also elsewhere on the board
/power stage/GND_U: Q2.3 (S), Q8.3 (S), Q14.3 (S), Q20.3 (S), R31.1
/power stage/GND_V: Q4.3 (S), Q10.3 (S), Q16.3 (S), Q22.3 (S), R32.1
/power stage/GND_W: Q6.3 (S), Q12.3 (S), Q18.3 (S), Q24.3 (S), R33.1
/power stage/MOS_TEMP: C54.1, R60.2, TH1.2; also elsewhere on the board
/power stage/PHASE_U: C19.2, C25.2, J1.1, Q1.3 (S), Q2.2 (D), Q7.3 (S), Q8.2 (D), Q13.3 (S), Q14.2 (D), Q19.3 (S), Q20.2 (D), R52.2, U1.14 (VSSA)
/power stage/PHASE_V: C20.2, C26.2, J2.1, Q3.3 (S), Q4.2 (D), Q9.3 (S), Q10.2 (D), Q15.3 (S), Q16.2 (D), Q21.3 (S), Q22.2 (D), R54.2, U2.14 (VSSA)
/power stage/PHASE_W: C21.2, C27.2, J3.1, Q5.3 (S), Q6.2 (D), Q11.3 (S), Q12.2 (D), Q17.3 (S), Q18.2 (D), Q23.3 (S), Q24.2 (D), R56.2, U3.14 (VSSA)
/power stage/VBOOT_U: C19.1, C25.1, D1.1 (K), U1.16 (VDDA)
/power stage/VBOOT_V: C20.1, C26.1, D2.1 (K), U2.16 (VDDA)
/power stage/VBOOT_W: C21.1, C27.1, D3.1 (K), U3.16 (VDDA)
/power stage/VSUPA_U: C31.1, C34.1, FB1.2, U4.6 (V+), U4.7 (REF1)
/power stage/VSUPA_V: C32.1, C35.1, FB2.2, U5.6 (V+), U5.7 (REF1)
/power stage/VSUPA_W: C33.1, C36.1, FB3.2, U6.6 (V+), U6.7 (REF1)
GND: C1.2, C2.2, C3.2, C4.1, C5.1, C6.1, C7.1, C8.1, C9.1, C10.2, C11.2, C12.2, C13.1, C14.1, C15.1, C16.2, C17.2, C18.2, C22.2, C23.2, C24.2, C28.2, C29.2, C30.2, C31.2, C32.2, C33.2, C34.2, C35.2, C36.2, C37.2, C38.2, C39.2, C40.2, C41.2, C43.2, C44.2, C46.2, C47.2, C49.2, C50.2, C52.2, C53.2, C54.2, C55.2, C56.2, C57.2, C58.2, C59.2, C60.2, C61.2, J5.1, J7.1, R13.2, R14.2, R15.2, R16.2, R17.2, R18.2, R19.1, R20.1, R21.1, R22.2, R23.2, R24.2, R31.4, R32.4, R33.4, R53.1, R55.1, R57.1, R58.1, R59.1, R60.1, R61.1, R62.1, R64.1, U1.4 (GND), U1.9 (VSSB), U2.4 (GND), U2.9 (VSSB), U3.4 (GND), U3.9 (VSSB), U4.2 (GND), U4.3 (REF2), U4.4 (GND), U5.2 (GND), U5.3 (REF2), U5.4 (GND), U6.2 (GND), U6.3 (REF2), U6.4 (GND); also elsewhere on the board
unnamed: C4.2, R1.1, R13.1, U1.1 (INA)
unnamed: C5.2, R4.1, R14.1, U2.1 (INA)
unnamed: C6.2, R7.1, R15.1, U3.1 (INA)
unnamed: C7.2, R2.1, R16.1, U1.2 (INB)
unnamed: C8.2, R5.1, R17.1, U2.2 (INB)
unnamed: C9.2, R8.1, R18.1, U3.2 (INB)
unnamed: C13.2, R3.1, R22.1, U1.5 (DIS)
unnamed: C14.2, R6.1, R23.1, U2.5 (DIS)
unnamed: C15.2, R9.1, R24.1, U3.5 (DIS)
unnamed: C16.1, R19.2, U1.6 (DT)
unnamed: C17.1, R20.2, U2.6 (DT)
unnamed: C18.1, R21.2, U3.6 (DT)
unnamed: C42.2, R58.2
unnamed: C45.2, R59.2
unnamed: C48.2, R61.2
unnamed: C51.2, R62.2
unnamed: D1.2 (A), R10.1
unnamed: D2.2 (A), R11.1
unnamed: D3.2 (A), R12.1
unnamed: Q1.1 (G), R25.2
unnamed: Q2.1 (G), R28.2
unnamed: Q3.1 (G), R26.2
unnamed: Q4.1 (G), R29.2
unnamed: Q5.1 (G), R27.2
unnamed: Q6.1 (G), R30.2
unnamed: Q7.1 (G), R34.2
unnamed: Q8.1 (G), R35.2
unnamed: Q9.1 (G), R36.2
unnamed: Q10.1 (G), R37.2
unnamed: Q11.1 (G), R38.2
unnamed: Q12.1 (G), R39.2
unnamed: Q13.1 (G), R40.2
unnamed: Q14.1 (G), R41.2
unnamed: Q15.1 (G), R42.2
unnamed: Q16.1 (G), R43.2
unnamed: Q17.1 (G), R44.2
unnamed: Q18.1 (G), R45.2
unnamed: Q19.1 (G), R46.2
unnamed: Q20.1 (G), R47.2
unnamed: Q21.1 (G), R48.2
unnamed: Q22.1 (G), R49.2
unnamed: Q23.1 (G), R50.2
unnamed: Q24.1 (G), R51.2
unnamed: R25.1, R34.1, R40.1, R46.1, U1.15 (OUTA)
unnamed: R26.1, R36.1, R42.1, R48.1, U2.15 (OUTA)
unnamed: R27.1, R38.1, R44.1, R50.1, U3.15 (OUTA)
unnamed: R28.1, R35.1, R41.1, R47.1, U1.10 (OUTB)
unnamed: R29.1, R37.1, R43.1, R49.1, U2.10 (OUTB)
unnamed: R30.1, R39.1, R45.1, R51.1, U3.10 (OUTB)
unnamed: R31.2, U4.8 (+)
unnamed: R31.3, U4.1 (-)
unnamed: R32.2, U5.8 (+)
unnamed: R32.3, U5.1 (-)
unnamed: R33.2, U6.8 (+)
unnamed: R33.3, U6.1 (-)
VDC: C40.1, C41.1, C42.1, C43.1, C44.1, C45.1, C46.1, C47.1, C48.1, C49.1, C50.1, C51.1, C52.1, C53.1, C55.1, C56.1, C57.1, C58.1, C59.1, C60.1, C61.1, J4.1, J6.1, Q1.2 (D), Q3.2 (D), Q5.2 (D), Q7.2 (D), Q9.2 (D), Q11.2 (D), Q13.2 (D), Q15.2 (D), Q17.2 (D), Q19.2 (D), Q21.2 (D), Q23.2 (D), R63.2; also elsewhere on the board

Notes on the sheet:
LOW SIDE decouple
HIGH SIDE supply & decouple
Aluminum
Film
Ceramics
F611BY685K100A
B41858C9477M000
C1206C105K1RACTU
VCCI decouple
DT=10xR ns / kOhm
Refference is 3.3V / 2
Ferrite bead for HF filtering
Each fet has its own gate resistor to even out switching losses
Bulk capacitance to compensate battery wire impedance
HF capacitance to compensate power stage impedance
HF snubbers
Pulldowns to introduce current in signal lines for noise immunity
Bootstrap supply for high side gates
Signal filter
Analog ground is kept sepparate

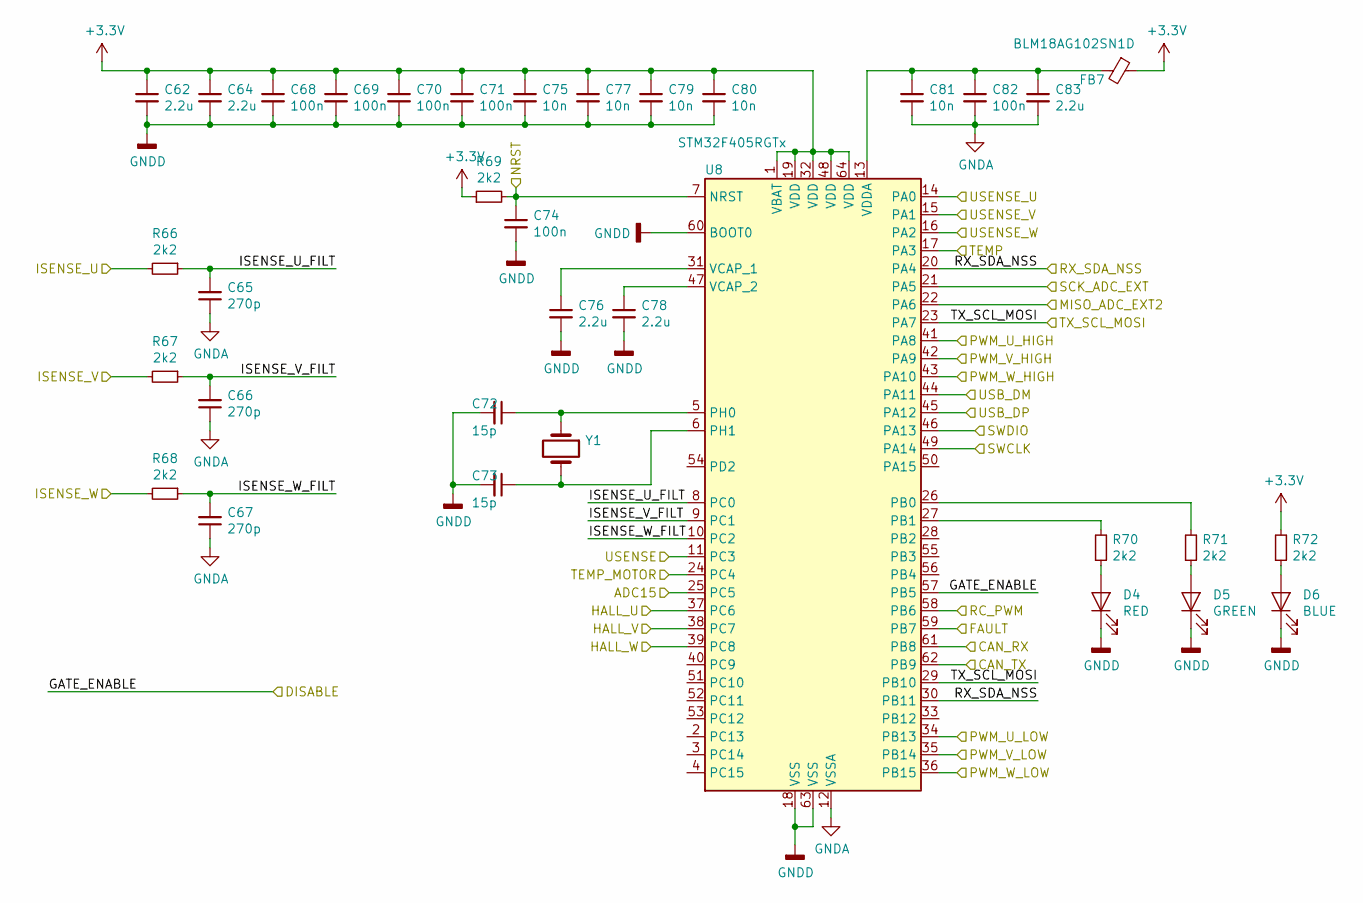
[picture p20: schematic besc g2 mcu.sch, BESC Gen 2]

Parts:
C62, C64, C76, C78, C83: 2.2u; C_0603_1608Metric
C65, C66, C67: 270p; C_0603_1608Metric
C68, C69, C70, C71, C74, C82: 100n; C_0603_1608Metric
C72, C73: 15p; C_0603_1608Metric
C75, C77, C79, C80, C81: 10n; C_0603_1608Metric
D4: RED; LED_0603_1608Metric
D5: GREEN; LED_0603_1608Metric
D6: BLUE; LED_0603_1608Metric
FB7: BLM18AG102SN1D; L_0603_1608Metric
R66, R67, R68, R69, R70, R71, R72: 2k2; R_0603_1608Metric
U8: STM32F405RGTx; LQFP-64_10x10mm_P0.5mm
Y1: MCSJK-7I-8.00-18-10-60-B-10; Crystal_SMD_5032-4Pin_5.0x3.2mm

Connections:
+3V3: C62.1, C64.1, C68.1, C69.1, C70.1, C71.1, C75.1, C77.1, C79.1, C80.1, FB7.1, R69.1, R72.2, U8.1 (VBAT), U8.19 (VDD), U8.32 (VDD), U8.48 (VDD), U8.64 (VDD); also elsewhere on the board
/io/CAN_RX: U8.61 (PB8); also elsewhere on the board
/io/CAN_TX: U8.62 (PB9); also elsewhere on the board
/io/HALL_U: U8.37 (PC6); also elsewhere on the board
/io/HALL_V: U8.38 (PC7); also elsewhere on the board
/io/HALL_W: U8.39 (PC8); also elsewhere on the board
/io/MOTOR_TEMP: U8.24 (PC4); also elsewhere on the board
/io/NRST: C74.1, R69.2, U8.7 (NRST); also elsewhere on the board
/io/RC_PWM: U8.58 (PB6); also elsewhere on the board
/io/RX: U8.20 (PA4), U8.30 (PB11); also elsewhere on the board
/io/SWCLK: U8.49 (PA14); also elsewhere on the board
/io/SWDIO: U8.46 (PA13); also elsewhere on the board
/io/TX: U8.23 (PA7), U8.29 (PB10); also elsewhere on the board
/io/USB_DM: U8.44 (PA11); also elsewhere on the board
/io/USB_DP: U8.45 (PA12); also elsewhere on the board
/mcu/DISABLE: U8.57 (PB5); also elsewhere on the board
/mcu/ISENSE_U: R66.2; also elsewhere on the board
/mcu/ISENSE_U_FILT: C65.2, R66.1, U8.8 (PC0)
/mcu/ISENSE_V: R67.2; also elsewhere on the board
/mcu/ISENSE_V_FILT: C66.2, R67.1, U8.9 (PC1)
/mcu/ISENSE_W: R68.2; also elsewhere on the board
/mcu/ISENSE_W_FILT: C67.2, R68.1, U8.10 (PC2)
/mcu/MISO_ADC_EXT2: U8.22 (PA6); also elsewhere on the board
/mcu/PWM_U_HIGH: U8.41 (PA8); also elsewhere on the board
/mcu/PWM_U_LOW: U8.34 (PB13); also elsewhere on the board
/mcu/PWM_V_HIGH: U8.42 (PA9); also elsewhere on the board
/mcu/PWM_V_LOW: U8.35 (PB14); also elsewhere on the board
/mcu/PWM_W_HIGH: U8.43 (PA10); also elsewhere on the board
/mcu/PWM_W_LOW: U8.36 (PB15); also elsewhere on the board
/mcu/SCK_ADC_EXT: U8.21 (PA5); also elsewhere on the board
/mcu/USENSE: U8.11 (PC3); also elsewhere on the board
/mcu/USENSE_U: U8.14 (PA0); also elsewhere on the board
/mcu/USENSE_V: U8.15 (PA1); also elsewhere on the board
/mcu/USENSE_W: U8.16 (PA2); also elsewhere on the board
/power stage/MOS_TEMP: U8.17 (PA3); also elsewhere on the board
GND: C62.2, C64.2, C65.1, C66.1, C67.1, C68.2, C69.2, C70.2, C71.2, C72.2, C73.2, C74.2, C75.2, C76.2, C77.2, C78.2, C79.2, C80.2, C81.2, C82.2, C83.2, D4.1 (K), D5.1 (K), D6.1 (K), U8.12 (VSSA), U8.18 (VSS), U8.60 (BOOT0), U8.63 (VSS); also elsewhere on the board
unnamed: C72.1, U8.5 (PH0), Y1.1
unnamed: C73.1, U8.6 (PH1), Y1.2
unnamed: C76.1, U8.31 (VCAP_1)
unnamed: C78.1, U8.47 (VCAP_2)
unnamed: C81.1, C82.1, C83.1, FB7.2, U8.13 (VDDA)
unnamed: D4.2 (A), R70.1
unnamed: D5.2 (A), R71.1
unnamed: D6.2 (A), R72.1
unnamed: R70.2, U8.27 (PB1)
unnamed: R71.2, U8.26 (PB0)

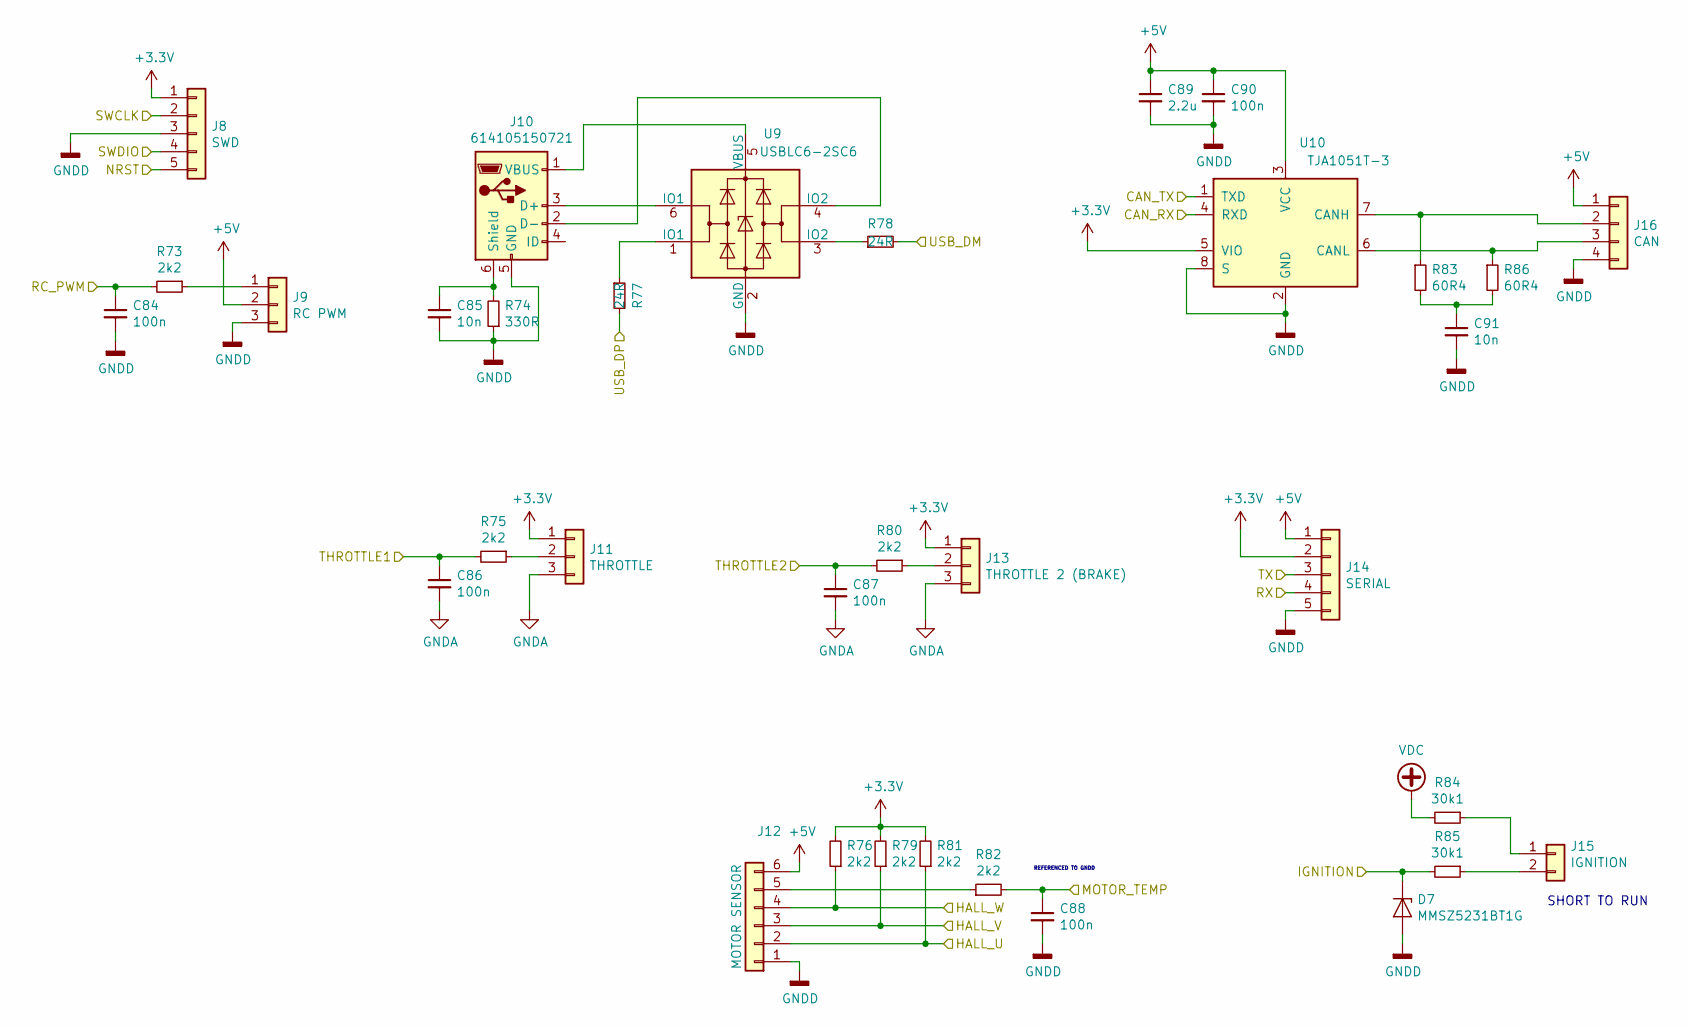
[picture p21: schematic besc g2 io.sch, BESC Gen 2]

Parts:
C84, C86, C87, C88, C90: 100n; C_0603_1608Metric
C85, C91: 10n; C_0603_1608Metric
C89: 2.2u; C_0603_1608Metric
D7: MMSZ5231BT1G; D_SOD-123
J8: SWD; PinHeader_1x05_P2.54mm_Vertical
J9: RC PWM; PinHeader_1x03_P2.54mm_Vertical
J10: 614105150721; USB_Micro-B_Wuerth_614105150721_Vertical_CircularHoles
J11: THROTTLE; PinHeader_1x03_P2.54mm_Vertical
J12: MOTOR SENSOR; PinHeader_1x06_P2.54mm_Vertical
J13: THROTTLE 2 (BRAKE); PinHeader_1x03_P2.54mm_Vertical
J14: SERIAL; PinHeader_1x05_P2.54mm_Vertical
J15: IGNITION; PinHeader_1x02_P2.54mm_Vertical
J16: CAN; PinHeader_1x04_P2.54mm_Vertical
R73, R75, R76, R79, R80, R81, R82: 2k2; R_0603_1608Metric
R74: 330R; R_0603_1608Metric
R77, R78: 24R; R_0603_1608Metric
R83, R86: 60R4; R_0603_1608Metric
R84, R85: 30k1; R_0603_1608Metric
U9: USBLC6-2SC6; SOT-666
U10: TJA1051T-3; SOIC-8_3.9x4.9mm_P1.27mm

Connections:
+3V3: J8.1, J11.1, J13.1, J14.2, R76.2, R79.2, R81.2, U10.5 (VIO); also elsewhere on the board
+5V: C89.1, C90.1, J9.2, J12.6, J14.1, J16.1, U10.3 (VCC); also elsewhere on the board
/io/CAN_RX: U10.4 (RXD); also elsewhere on the board
/io/CAN_TX: U10.1 (TXD); also elsewhere on the board
/io/HALL_U: J12.2, R81.1; also elsewhere on the board
/io/HALL_V: J12.3, R79.1; also elsewhere on the board
/io/HALL_W: J12.4, R76.1; also elsewhere on the board
/io/IGNITION: D7.1 (K), R85.2; also elsewhere on the board
/io/MOTOR_TEMP: C88.1, R82.2; also elsewhere on the board
/io/NRST: J8.5; also elsewhere on the board
/io/RC_PWM: C84.1, R73.2; also elsewhere on the board
/io/RX: J14.4; also elsewhere on the board
/io/SWCLK: J8.2; also elsewhere on the board
/io/SWDIO: J8.4; also elsewhere on the board
/io/TX: J14.3; also elsewhere on the board
/io/USB_DM: R78.2; also elsewhere on the board
/io/USB_DP: R77.2; also elsewhere on the board
/mcu/MISO_ADC_EXT2: C87.1, R80.2; also elsewhere on the board
/mcu/SCK_ADC_EXT: C86.1, R75.2; also elsewhere on the board
GND: C84.2, C85.2, C86.2, C87.2, C88.2, C89.2, C90.2, C91.2, D7.2 (A), J8.3, J9.3, J10.5 (GND), J11.3, J12.1, J13.3, J14.5, J16.4, R74.1, U9.2 (GND), U10.2 (GND), U10.8 (S); also elsewhere on the board
unnamed: C85.1, J10.6 (Shield), R74.2
unnamed: C91.1, R83.2, R86.2
unnamed: J9.1, R73.1
unnamed: J10.1 (VBUS), U9.5 (VBUS)
unnamed: J10.2 (D-), U9.4 (IO2)
unnamed: J10.3 (D+), U9.6 (IO1)
unnamed: J11.2, R75.1
unnamed: J12.5, R82.1
unnamed: J13.2, R80.1
unnamed: J15.1, R84.1
unnamed: J15.2, R85.1
unnamed: J16.2, R83.1, U10.7 (CANH)
unnamed: J16.3, R86.1, U10.6 (CANL)
unnamed: R77.1, U9.1 (IO1)
unnamed: R78.1, U9.3 (IO2)
VDC: R84.2; also elsewhere on the board

Notes on the sheet:
REFERENCED TO GNDD
SHORT TO RUN

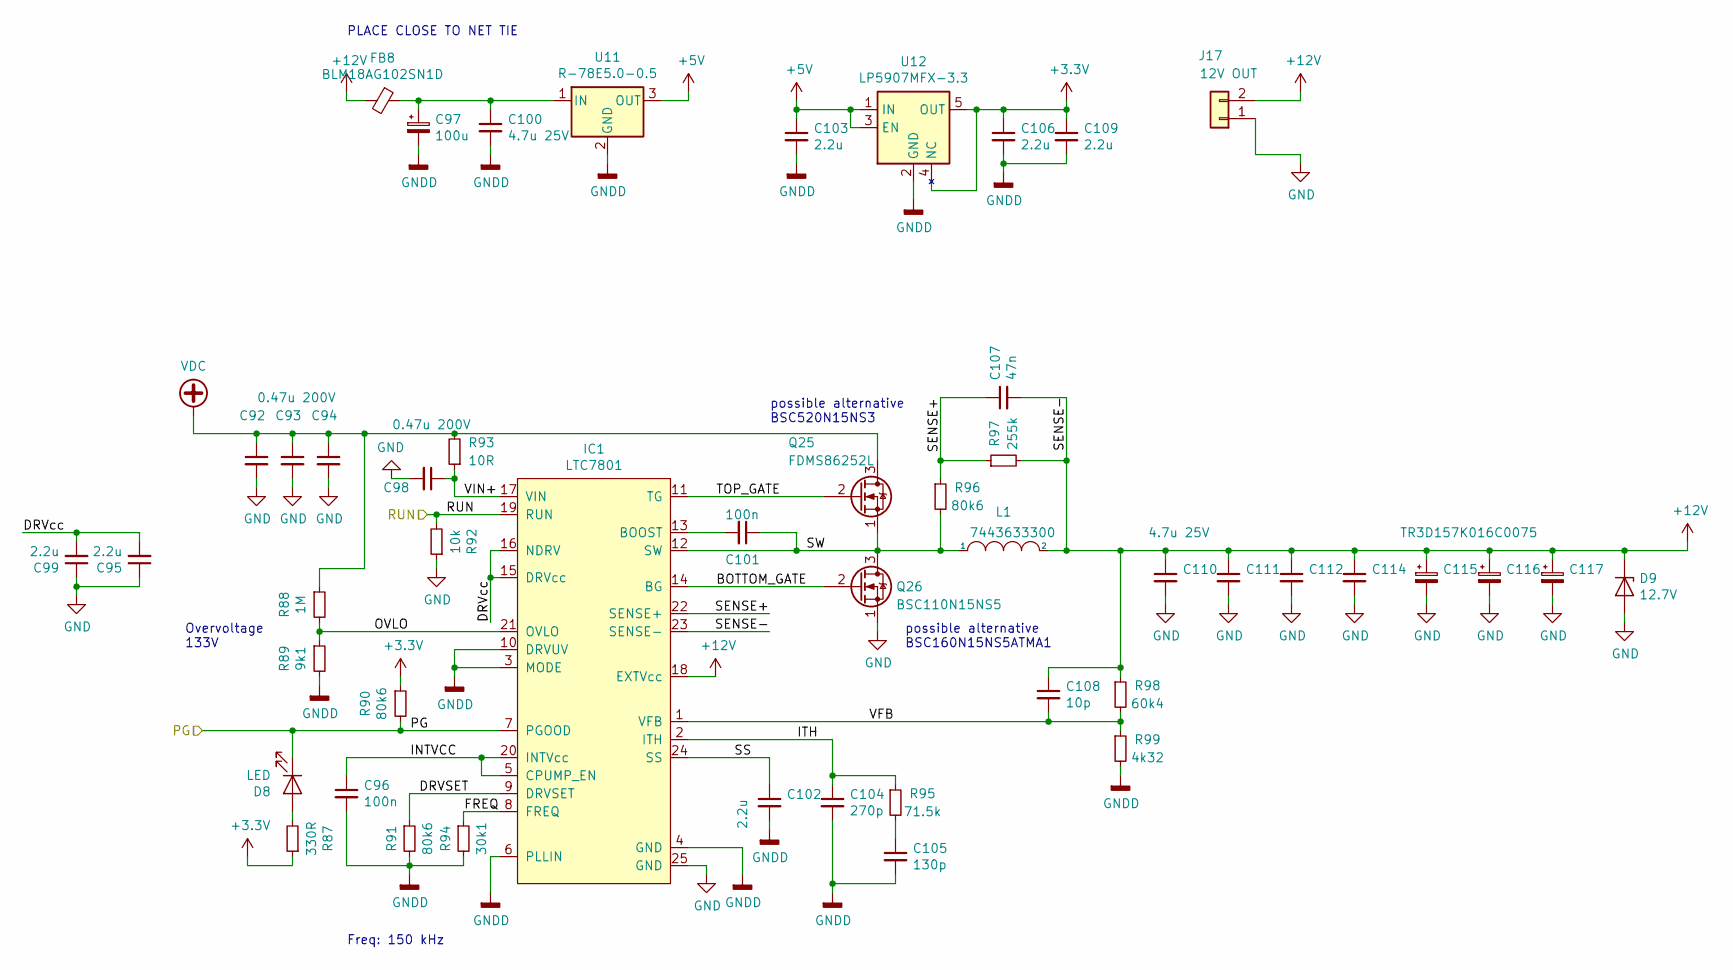
[picture p22: schematic besc g2 pwr mng.sch, BESC Gen 2]

Parts:
C92, C93, C94, C98: 0.47u 200V; C_1210_3225Metric
C95, C99, C102, C103, C106, C109: 2.2u; C_0603_1608Metric
C96, C101: 100n; C_0603_1608Metric
C97: 100u; CP_EIA-6032-28_Kemet-C; PART TAJD107M016RNJ
C100, C110, C111, C112, C114: 4.7u 25V; C_1206_3216Metric
C104: 270p; C_0603_1608Metric
C105: 130p; C_0603_1608Metric
C107: 47n; C_0603_1608Metric
C108: 10p; C_0603_1608Metric
C115, C116, C117: TR3D157K016C0075; CP_EIA-7343-31_Kemet-D
D8: LED; LED_0603_1608Metric
D9: 12.7V; D_SMA
FB8: BLM18AG102SN1D; L_0603_1608Metric
IC1: LTC7801; QFN-24-1EP_4x5mm_P0.5mm_EP2.65x3.65mm
J17: 12V OUT; AMASS_XT30U-M_1x02_P5.0mm_Vertical
L1: 7443633300; WE-HCF-2013
Q25: FDMS86252L; TDSON-8-MOS
Q26: BSC110N15NS5; TDSON-8-MOS
R87: 330R; R_0603_1608Metric
R88: 1M; R_0603_1608Metric
R89: 9k1; R_0603_1608Metric
R90, R91, R96: 80k6; R_0603_1608Metric
R92: 10k; R_0603_1608Metric
R93: 10R; R_0805_2012Metric
R94: 30k1; R_0603_1608Metric
R95: 71.5k; R_0603_1608Metric
R97: 255k; R_0603_1608Metric
R98: 60k4; R_0603_1608Metric
R99: 4k32; R_0603_1608Metric
U11: R-78E5.0-0.5; Converter_DCDC_RECOM_R-78E-0.5_THT
U12: LP5907MFX-3.3; SOT-23-5

Connections:
+3V3: C106.1, C109.1, R87.1, R90.1, U12.4 (NC), U12.5 (OUT); also elsewhere on the board
+5V: C103.1, U11.3 (OUT), U12.1 (IN), U12.3 (EN); also elsewhere on the board
+12V: C107.2, C108.1, C110.1, C111.1, C112.1, C114.1, C115.1, C116.1, C117.1, D9.1 (K), FB8.2, IC1.18 (EXTVcc), IC1.23 (SENSE-), J17.2, L1.2, R97.2, R98.1; also elsewhere on the board
/io/IGNITION: IC1.19 (RUN), R92.2; also elsewhere on the board
/pwr mng/BOTTOM_GATE: IC1.14 (BG), Q26.2 (G)
/pwr mng/DRVSET: IC1.9 (DRVSET), R91.1
/pwr mng/DRVcc: C95.2, C99.2, IC1.15 (DRVcc), IC1.16 (NDRV)
/pwr mng/FREQ: IC1.8 (FREQ), R94.1
/pwr mng/INTVCC: C96.1, IC1.5 (CPUMP_EN), IC1.20 (INTVcc)
/pwr mng/ITH: C104.1, IC1.2 (ITH), R95.1
/pwr mng/OVLO: IC1.21 (OVLO), R88.2, R89.1
/pwr mng/PG: D8.1 (K), IC1.7 (PGOOD), R90.2
/pwr mng/SENSE+: C107.1, IC1.22 (SENSE+), R96.1, R97.1
/pwr mng/SS: C102.1, IC1.24 (SS)
/pwr mng/SW: C101.1, IC1.12 (SW), L1.1, Q25.1 (S), Q26.3 (D), R96.2
/pwr mng/TOP_GATE: IC1.11 (TG), Q25.2 (G)
/pwr mng/VFB: C108.2, IC1.1 (VFB), R98.2, R99.1
/pwr mng/VIN+: C98.1, IC1.17 (VIN), R93.1
GND: C92.2, C93.2, C94.2, C95.1, C96.2, C97.2, C98.2, C99.1, C100.2, C102.2, C103.2, C104.2, C105.2, C106.2, C109.2, C110.2, C111.2, C112.2, C114.2, C115.2, C116.2, C117.2, D9.2 (A), IC1.3 (MODE), IC1.4 (GND), IC1.6 (PLLIN), IC1.10 (DRVUV), IC1.25 (GND), J17.1, Q26.1 (S), R89.2, R91.2, R92.1, R94.2, R99.2, U11.2 (GND), U12.2 (GND); also elsewhere on the board
unnamed: C97.1, C100.1, FB8.1, U11.1 (IN)
unnamed: C101.2, IC1.13 (BOOST)
unnamed: C105.1, R95.2
unnamed: D8.2 (A), R87.2
VDC: C92.1, C93.1, C94.1, Q25.3 (D), R88.1, R93.2; also elsewhere on the board

Notes on the sheet:
PLACE CLOSE TO NET TIE
Overvoltage 133V
Freq: 150 kHz
possible alternative BSC160N15NS5ATMA1
possible alternative BSC520N15NS3

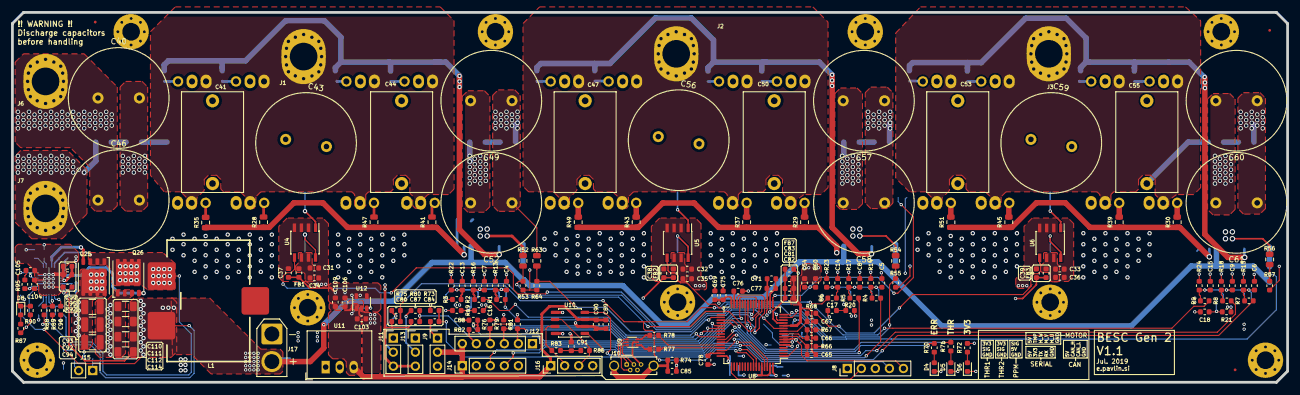
[picture p23: board besc g2.kicad_pcb from above]

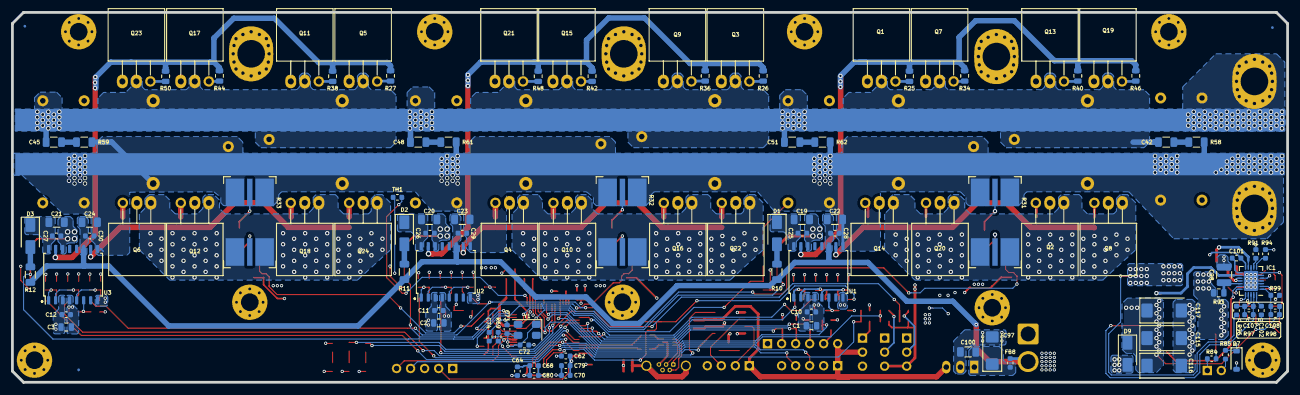
[picture p24: board besc g2.kicad_pcb from below]

Board: 4 copper layers, 231.0 x 67.0 mm, 300 parts (114 on the bottom side), 150 nets.
