galpavlin/BESC-G2/(commit log)

2019-04-05 power stage layout draft
    [besc g2 io.sch, besc g2 mcu.sch, besc g2 power.sch, besc g2 pwr mng.sch, besc g2.sch]
2019-04-22 isolated drivers, layout
    [besc g2 io.sch, besc g2 mcu.sch, besc g2 power.sch, besc g2 pwr mng.sch, besc g2.kicad_pcb, besc g2.sch]
2019-04-24 12V PS, isolated gate drivers
    [besc g2 io.sch, besc g2 mcu.sch, besc g2 power.sch, besc g2 pwr mng.sch, besc g2.kicad_pcb, besc g2.sch]
2019-06-24 layout and routing progress
    [_saved_besc g2 mcu.sch, besc g2 BOM.xlsx, besc g2 io.sch, besc g2 power.sch, besc g2 pwr mng.sch, besc g2.kicad_pcb, besc g2.sch]
2019-06-30 finished routing
    [_saved_besc g2 mcu.sch, besc g2 io.sch, besc g2 mcu.sch, besc g2.kicad_pcb, besc g2.sch]
2019-07-14 finished routing, added bom and step
    [BESC G2 Vinit BOM.ods, besc g2 BOM.xlsx, besc g2 io.sch, besc g2 mcu.sch, besc g2 power.sch, besc g2 pwr mng.sch, besc g2.kicad_pcb, besc g2.sch]
2019-07-17 replaced Al capacitors with shorter ones
    [BESC G2 Vinit BOM.ods, besc g2 power.sch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]
2019-07-21 changed enclosure in BOM
    [BESC G2 Vinit BOM.ods]
2019-07-26 fixed bom
    [BESC G2 Vinit BOM.ods]
2019-08-21 added assembly drawing
    [BESC G2 Vinit BOM.ods, besc g2 pwr mng.sch, besc g2.kicad_pcb, bus bar.SLDPRT]
2020-08-25 fixed schematic, added firmware files
    [BESC G2 Vinit BOM.ods, besc g2 pwr mng.sch, besc g2.kicad_pcb, spacers.STL, spacers1.STL, spacers2.STL, top plastic 1.STL, top plastic 2.STL]
2021-05-26 removed inverter for gate enable, fixed bugs on pcb
    [BESC G2 V1.1 BOM.ods, BESC G2 Vinit BOM.ods, Mouser order.xlsx, besc g2 mcu.sch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]
